baoshi/VGMPlayer/sw/doc/main_description.docx

Top state

Input: None

Events:

Event | Action
EVT_ENTRY
EVT_EXIT
EVT_START | Start browser state
EVT_OPEN_BRIGHTNESS_POPUP | Sender: [SETTING] button in Browser_Nodisk, Browser_Disk, Browser_Baddisk Popup brightness setting box
EVT_CLOSE_BRIGHTNESS_POPUP | Sender: Close brightness setting box
EVT_CLOSE_ALERT | Sender: Timer or manually sent from alert box. Close alert box

Browser state

Input: None

Events:

Event | Action
EVT_ENTRY | Create screen Create virtual buttons Setup inputs Create other UI elements Arm UI update timer
EVT_EXIT | Disarm UI update timer Delete virtual buttons (probably not necessary)
EVT_START | Start browser_nodisk state
EVT_BROWSER_UI_UPDATE | Update top bar

Browser_Nodisk state

Input:

Key | Button | | Keypad
| LVGL Event | Application Event
SETTING | LV_EVENT_SHORT_CLICKED | EVT_OPEN_BRIGHTNESS_POPUP
BACK | LV_EVENT_SHORT_CLICKED | EVT_BUTTON_BACK_CLICKED
PLAY
UP
DOWN

Events:

Event | Action
EVT_ENTRY | Setup inputs
EVT_EXIT
EVT_START | -
EVT_DISK_INSERTED | Sender: disk module Transit to browser_disk state

Browser_Baddisk state

Input:

Key | Button | | Keypad
| LVGL Event | Application Event
SETTING | LV_EVENT_SHORT_CLICKED | EVT_OPEN_BRIGHTNESS_POPUP
BACK | LV_EVENT_SHORT_CLICKED | EVT_BUTTON_BACK_CLICKED
PLAY
UP
DOWN

Events:

Event | Action
EVT_ENTRY | Setup inputs
EVT_EXIT
EVT_START | -
EVT_DISK_EJECTED | Sender: disk module. Transit to browser_nodisk state.

Browser_Disk state

Input:

Key | Button | | Keypad
| LVGL Event | Application Event
SETTING | LV_EVENT_SHORT_CLICKED | EVT_OPEN_BRIGHTNESS_POPUP
BACK | LV_EVENT_SHORT_CLICKED | EVT_BUTTON_BACK_CLICKED
PLAY | | | LV_KEY_ENTER
UP | | | LV_KEY_PREV
DOWN | | | LV_KEY_NEXT

Events:

Event | Action
EVT_ENTRY | Setup inputs and input group (for keypad) Create new catalog object from root folder or restore previous opened folder, if successful, populate file list; otherwise send EVT_DISK_ERROR event.
EVT_EXIT | Delete input group
EVT_START | -
EVT_BROWSER_PLAY_CLICKED | If clicked on a file, save history and transit to player state If clicked on a directory, save history, populate that directory (send EVT_DISK_ERROR if fail). If clicked on parent directory ([..]), send EVT_BUTTON_BACK_CLICKED. If clicked on page up/down, populate previous/next page.
EVT_BUTTON_BACK_CLICKED | If not root folder, discard one level of history, create catalog on parent folder and populate, send EVT_DISK_ERROR if failed.
EVT_DISK_ERROR | Sender: browser_disk event handler during disk I/O error. Transit to browser_baddisk state.
EVT_DISK_EJECTED | Sender: disk module. Transit to browser_nodisk state.

Player state

Input:

Key | Button | | Keypad
| LVGL Event | Application Event
SETTING | LV_EVENT_SHORT_CLICKED | EVT_OPEN_VOLUME_POPUP
BACK | LV_EVENT_SHORT_CLICKED | EVT_BUTTON_BACK_CLICKED
PLAY | LV_EVENT_SHORT_CLICKED | EVT_BUTTON_PLAY_CLICKED
UP | LV_EVENT_SHORT_CLICKED | EVT_BUTTON_UP_CLICKED
DOWN | LV_EVENT_SHORT_CLICKED | EVT_BUTTON_DOWN_CLICKED

Events:

Event | Action
EVT_ENTRY | Create screen. Create virtual buttons. Setup inputs. Create other UI elements. Arm UI update timer.
EVT_EXIT | Disarm UI update timer. Delete virtual buttons (probably not necessary).
EVT_START | Send EVT_BUTTON_PLAY_CLICKED.
EVT_BROWSER_UI_UPDATE | Update top bar.
EVT_BUTTON_PLAY_CLICKED | Get the current file, save history, determine file extension and transit to corresponding playing state. If error, popup alert.
EVT_PLAYER_PLAY_NEXT | Find next file (next or previous depending on nav_dir). If found, send EVT_BUTTON_PLAY_CLICKED. If reach end of catalog, save last played file in history. If disk error, send EVT_DISK_ERROR.
EVT_BUTTON_UP_CLICKED | Set nav_dir to up and send EVT_PLAYER_PLAY_NEXT.
EVT_BUTTON_DOWN_CLICKED | Set nav_dir to down and send EVT_PLAYER_PLAY_NEXT.
EVT_OPEN_VOLUME_POPUP | Sender: [SETTING] button in this state and sub-state. Pop up volume setting box.
EVT_CLOSE_VOLUME_POPUP | Sender: Volume popup upon [BACK] clicked. Close volume setting box.
EVT_CLOSE_VOLUME_POPUP_NEXT | Sender: Volume popup upon [SETTING] clicked. Send EVT_OPEN_BRIGHTNESS_POPUP.
EVT_BUTTON_BACK_CLICKED | Transit to browser_disk state.
EVT_DISK_ERROR | Transit to browser_baddisk state.
EVT_DISK_EJECTED | Sender: disk module. Transit to browser_nodisk state.
EVT_HEADPHONE_PLUGGED | If volume setting box already shown, refresh it
EVT_HEADPHONE_UNPLUGGED | If volume setting box already shown, refresh it

Player_S16 state

Input:

Key | Button | | Keypad
| LVGL Event | Application Event
SETTING | LV_EVENT_SHORT_CLICKED | EVT_OPEN_VOLUME_POPUP
BACK | LV_EVENT_SHORT_CLICKED | EVT_BUTTON_BACK_CLICKED
PLAY | LV_EVENT_SHORT_CLICKED | EVT_BUTTON_PLAY_CLICKED
UP | LV_EVENT_SHORT_CLICKED | EVT_BUTTON_UP_CLICKED
DOWN | LV_EVENT_SHORT_CLICKED | EVT_BUTTON_DOWN_CLICKED

Events:

Event | Action
EVT_ENTRY | Setup inputs. Create decoder. Setup audio system and start playback.
EVT_EXIT | Finish audio system. If config dirty, save config. (possible config changed during playback) Destroy decoder.
EVT_START
EVT_BUTTON_PLAY_CLICKED | Pause/Resume playback.
EVT_BUTTON_BACK_CLICKED | Stop audio playback. Set nav_dir to 0. Audio system will send EVT_AUDIO_SONG_ENDDED after last audio sample played.
EVT_BUTTON_UP_CLICKED | Stop audio playback. Set nav_dir to up. Audio system will send EVT_AUDIO_SONG_ENDDED after last audio sample played.
EVT_BUTTON_DOWN_CLICKED | Stop audio playback. Set nav_dir to down. Audio system will send EVT_AUDIO_SONG_ENDDED after last audio sample played.
EVT_AUDIO_SONG_ENDDED | If nav_dir is 0, transit to browser_disk state. Otherwise send EVT_PLAYER_PLAY_NEXT (player state to handle)

Popup Brightness

Input:

Key | Button | | Keypad
| LVGL Event | Application Event
SETTING | LV_EVENT_SHORT_CLICKED | EVT_CLOSE_BRIGHTNESS_POPUP
BACK | LV_EVENT_SHORT_CLICKED | EVT_CLOSE_BRIGHTNESS_POPUP
PLAY
UP | | | LV_KEY_UP
DOWN | | | LV_KEY_DOWN

Creation | Called by top state when handling EVT_OPEN_BRIGHTNESS_POPUP. Save current input configuration. Setup input. Create slider box, bind slider to UP/DOWN and set slider VALUE_CHANGED callback. Setup auto close timer to emit EVT_CLOSE_BRIGHTNESS (handled by top state).
Callback | Change brightness. Set config dirty. Reset auto close timer.
Close | Called by top state when handling EVT_CLOSE_BRIGHTNESS_POPUP. Save config if not busy and config dirty. Delete input group. Close slider box. Restore original input configuration.

Popup Volume

Input:

Key | Button | | Keypad
| LVGL Event | Application Event
SETTING | LV_EVENT_SHORT_CLICKED | EVT_CLOSE_VOLUME_POPUP_NEXT
BACK | LV_EVENT_SHORT_CLICKED | EVT_CLOSE_VOLUME_POPUP
PLAY
UP | | | LV_KEY_UP
DOWN | | | LV_KEY_DOWN

Creation | Called by player state when handling EVT_OPEN_VOLUME_POPUP. Save current input configuration. Setup input. Create slider box, bind slider to UP/DOWN and set slider VALUE_CHANGED callback.
Callback | Change volume for active device. Set config dirty. Reset auto close timer.
Close | Called by player state when handling EVT_CLOSE_VOLUME_POPUP and EVT_CLOSE_VOLUME_POPUP_NEXT. Save config if not busy and config dirty. Delete input group. Close slider box. Restore original input configuration.

Popup Alert

Input:

Key | Button | | Keypad
| LVGL Event | Application Event
SETTING
BACK
PLAY | | | LV_KEY_ENTER
UP
DOWN

Creation | Called by player state on various occasions when error occurred. Save current input configuration. Setup input. Create alert popup. Bind KEY_ENTER callback. Setup auto close timer to emit EVT_CLOSE_ALERT (handled by top state).
Callback | When ENTER key pressed, stop auto close timer. When ENTER key clicked, send EVT_CLOSE_ALERT (handled by top state).
Close | Called by top state when handling EVT_CLOSE_ALERT. Delete input group. Close alert. Restore original input configuration.
