baoshi/VGMPlayer/hw/doc/XKTF-015-G.pdf

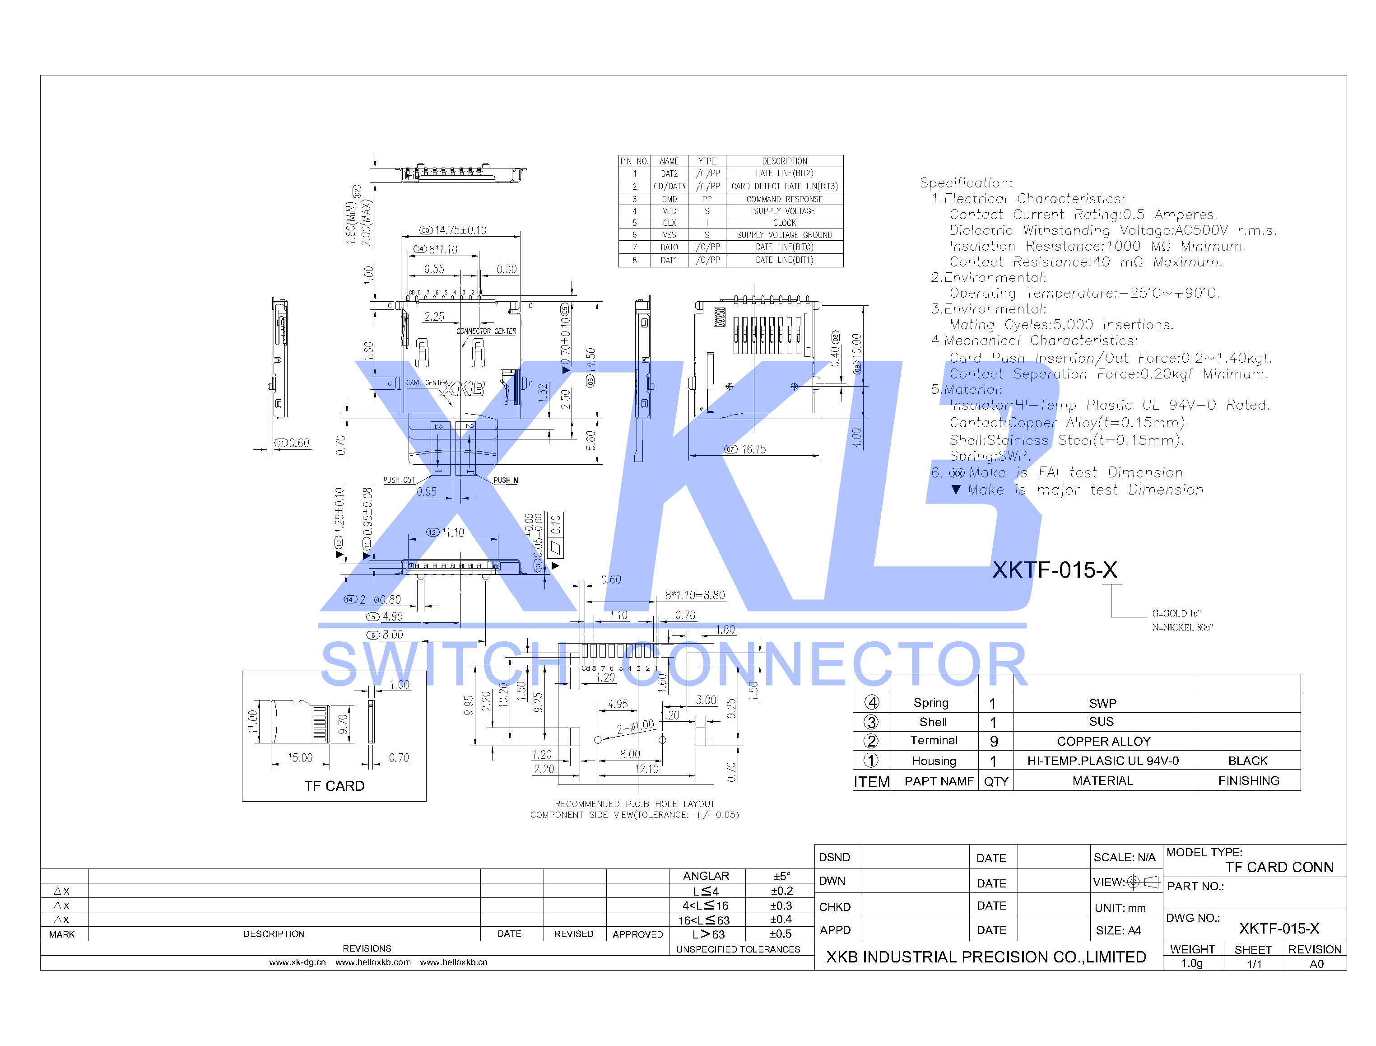
[picture p1: page 1]
