baoshi/VGMPlayer/hw/VGMPlayer.kicad_pcb

## KiCad design hw/VGMPlayer.kicad_pcb (2023-02-13)

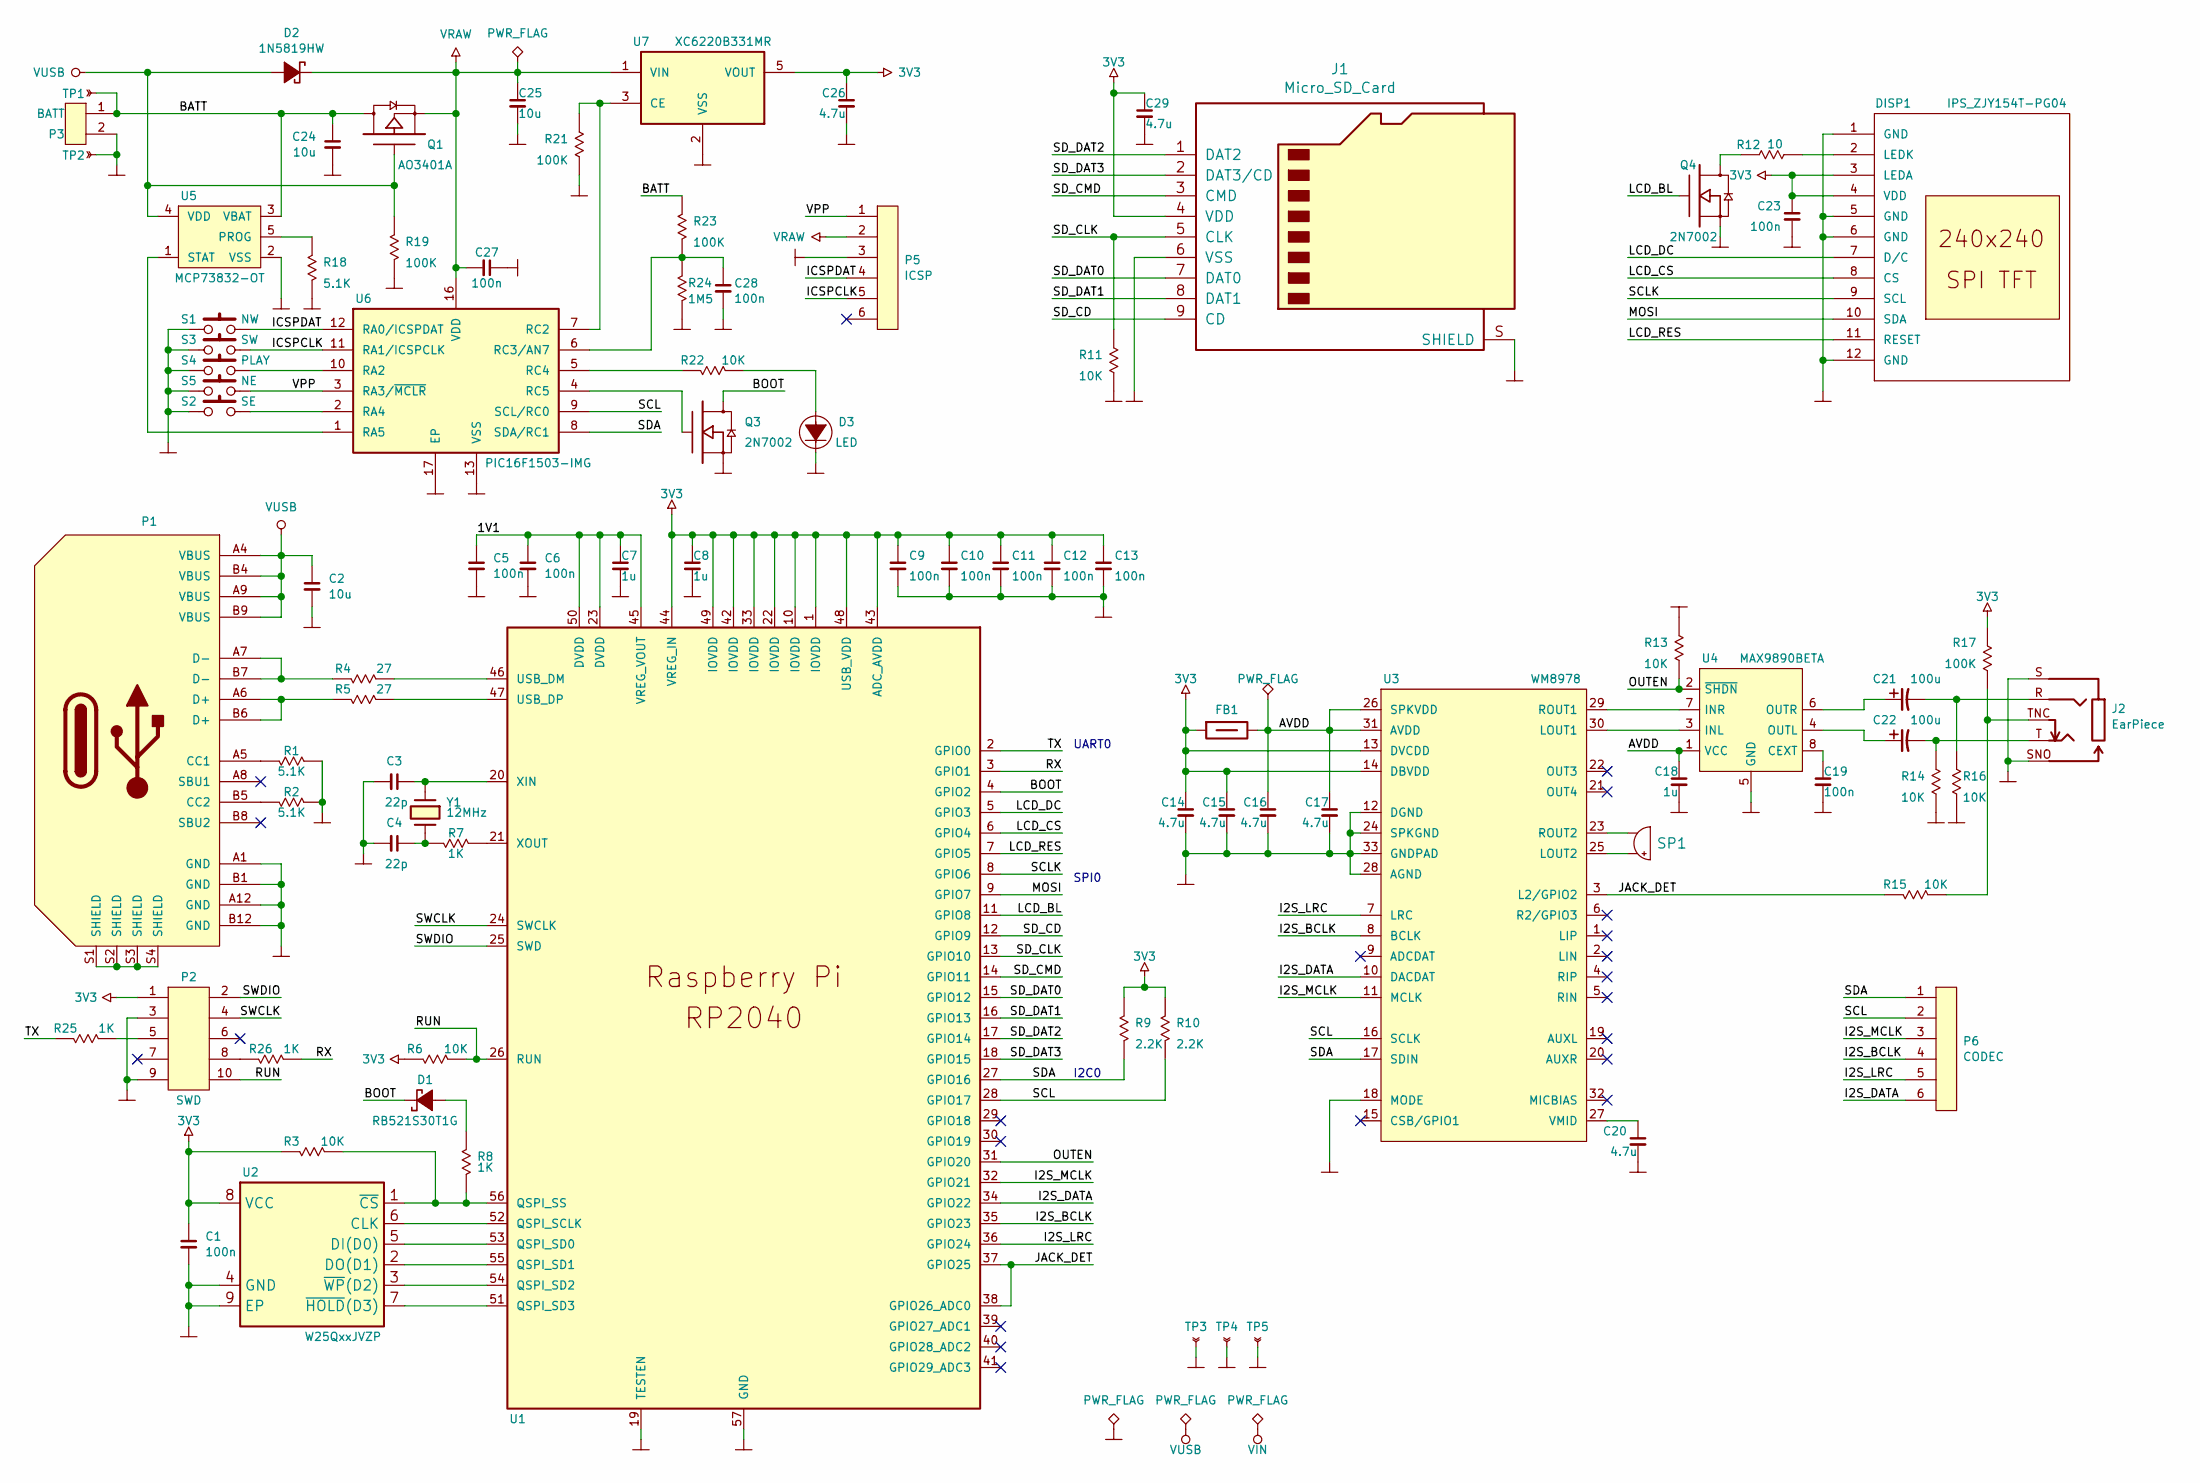
[picture p3: schematic VGMPlayer.kicad_sch]

Parts:
C1, C5, C6, C9, C10, C11, C12, C13, C19, C23, C27, C28: 100n; C_0402
C2, C25: 10u; C_0603
C3, C4: 22p; C_0402
C7, C8, C18: 1u; C_0603
C14, C26, C29: 4.7u; C_0603
C15, C16, C17, C20: 4.7u; C_0603; JLCPN C77044
C21, C22: 100u; CP_5x5.3
C24: 10u; C_0603; JLCPN C77044
D1: RB521S30T1G; D_SOD-523
D2: 1N5819HW; D_SOD-123
D3: LED; D_LED_0805_Edge_Lit
DISP1: IPS_ZJY154T-PG04
FB1: FB; L_0805
J1: Micro_SD_Card; XKB_XKTF-015-X
J2: EarPiece; XKB_PJ-327A0-SMT
P1: USB_C_Receptacle_16P; HRO_TYPE-C-31-M-12
P2: SWD; PINHDR-THT-50mil-02x05
P3: BATT; MLX_PicoBlade-Horz-01x02-1.25P
P5: ICSP; PINHDR-THT-50mil-01x06
P6: CODEC; PINHDR-THT-50mil-01x06
Q1: AO3401A; SOT-23-3
Q3, Q4: 2N7002; SOT-523
R1, R2, R18: 5.1K; R_0402
R3, R6, R11, R13, R14, R15, R16, R22: 10K; R_0402
R4, R5: 27; R_0402
R7, R8, R25, R26: 1K; R_0402
R9, R10: 2.2K; R_0402
R12: 10; R_0603
R17, R19, R21, R23: 100K; R_0402
R24: 1M5; R_0402
S1: NW; MultiButton
S2: SE; MultiButton
S3: SW; MultiButton
S4: PLAY; MultiButton
S5: NE; MultiButton
SP1: Speaker; iPhone8Speaker
TP1, TP2, TP3, TP4, TP5: TP; TP_THT-Pad-0.8
U1: RP2040
U2: W25QxxJVZP; WSON-8-1EP_5x6x1.27P_EP4.3x3.4
U3: WM8978; QFN-32-1EP_5x5x0.5P_EP3.45
U4: MAX9890BETA; TDFN-8-1EP_3x3x0.65P_EP2.3x1.5
U5: MCP73832-OT; SOT-23-5
U6: PIC16F1503-IMG; QFN-16-1EP_3x3x0.5P_EP1.1
U7: XC6220B331MR; SOT-23-5
Y1: 12MHz; XTAL_3225_4P

Connections:
3V3: C1.1, C8.1, C9.1, C10.1, C11.1, C12.1, C13.1, C14.1, C15.1, C23.1, C26.1, C29.1, DISP1.3 (LEDA), DISP1.4 (VDD), FB1.2, J1.4 (VDD), P2.1, R3.2, R6.2, R9.1, R10.1, R17.1, U1.1 (IOVDD), U1.10 (IOVDD), U1.22 (IOVDD), U1.33 (IOVDD), U1.42 (IOVDD), U1.43 (ADC_AVDD), U1.44 (VREG_IN), U1.48 (USB_VDD), U1.49 (IOVDD), U2.8 (VCC), U3.13 (DVCDD), U3.14 (DBVDD), U7.5 (VOUT)
/1V1: C5.1, C6.1, C7.1, U1.23 (DVDD), U1.45 (VREG_VOUT), U1.50 (DVDD)
/AVDD: C16.1, C17.1, C18.1, FB1.1, U3.26 (SPKVDD), U3.31 (AVDD), U4.1 (VCC)
/BATT: C24.1, P3.1, Q1.3 (D), R23.1, TP1.1, U5.3 (VBAT)
/BOOT: D1.K, Q3.3 (D), U1.4 (GPIO2)
/I2S_BCLK: P6.4, U1.35 (GPIO23), U3.8 (BCLK)
/I2S_DATA: P6.6, U1.34 (GPIO22), U3.10 (DACDAT)
/I2S_LRC: P6.5, U1.36 (GPIO24), U3.7 (LRC)
/I2S_MCLK: P6.3, U1.32 (GPIO21), U3.11 (MCLK)
/ICSPCLK: P5.5, S3.2, U6.11 (RA1/ICSPCLK)
/ICSPDAT: P5.4, S1.2, U6.12 (RA0/ICSPDAT)
/JACK_DET: R15.2, U1.37 (GPIO25), U1.38 (GPIO26_ADC0), U3.3 (L2/GPIO2)
/LCD_BL: Q4.1 (G), U1.11 (GPIO8)
/LCD_CS: DISP1.8 (CS), U1.6 (GPIO4)
/LCD_DC: DISP1.7 (D/C), U1.5 (GPIO3)
/LCD_RES: DISP1.11 (RESET), U1.7 (GPIO5)
/MOSI: DISP1.10 (SDA), U1.9 (GPIO7)
/OUTEN: R13.2, U1.31 (GPIO20), U4.2 (~SHDN)
/RUN: P2.10, R6.1, U1.26 (RUN)
/RX: R26.1, U1.3 (GPIO1)
/SCL: P6.2, R10.2, U1.28 (GPIO17), U3.16 (SCLK), U6.9 (SCL/RC0)
/SCLK: DISP1.9 (SCL), U1.8 (GPIO6)
/SDA: P6.1, R9.2, U1.27 (GPIO16), U3.17 (SDIN), U6.8 (SDA/RC1)
/SD_CD: J1.9 (CD), U1.12 (GPIO9)
/SD_CLK: J1.5 (CLK), R11.1, U1.13 (GPIO10)
/SD_CMD: J1.3 (CMD), U1.14 (GPIO11)
/SD_DAT0: J1.7 (DAT0), U1.15 (GPIO12)
/SD_DAT1: J1.8 (DAT1), U1.16 (GPIO13)
/SD_DAT2: J1.1 (DAT2), U1.17 (GPIO14)
/SD_DAT3: J1.2 (DAT3/CD), U1.18 (GPIO15)
/SWCLK: P2.4, U1.24 (SWCLK)
/SWDIO: P2.2, U1.25 (SWD)
/TX: R25.2, U1.2 (GPIO0)
/VPP: P5.1, S5.2, U6.3 (RA3/~MCLR)
GND: C1.2, C2.2, C3.2, C4.2, C5.2, C6.2, C7.2, C8.2, C9.2, C10.2, C11.2, C12.2, C13.2, C14.2, C15.2, C16.2, C17.2, C18.2, C19.2, C20.2, C23.2, C24.2, C25.2, C26.2, C27.1, C28.2, C29.2, D3.K, DISP1.1 (GND), DISP1.5 (GND), DISP1.6 (GND), DISP1.12 (GND), J1.6 (VSS), J1.S (SHIELD), J2.S, J2.SNO, P1.A1 (GND), P1.A12 (GND), P1.B1 (GND), P1.B12 (GND), P2.3, P2.9, P3.2, P5.3, Q3.2 (S), Q4.2 (S), R1.1, R2.1, R11.2, R13.1, R14.2, R16.2, R18.2, R19.2, R21.2, R24.2, S1.1, S2.1, S3.1, S4.1, S5.1, TP2.1, TP3.1, TP4.1, TP5.1, U1.19 (TESTEN), U1.57 (GND), U2.4 (GND), U2.9 (EP), U3.12 (DGND), U3.18 (MODE), U3.24 (SPKGND), U3.28 (AGND), U3.33 (GNDPAD), U4.5 (GND), U4.9 (GND), U5.2 (VSS), U6.13 (VSS), U6.17 (EP), U7.2 (VSS)
unnamed: C3.1, U1.20 (XIN), Y1.1 (OSC1)
unnamed: C4.1, R7.2, Y1.3 (OSC2)
unnamed: C19.1, U4.8 (CEXT)
unnamed: C20.1, U3.27 (VMID)
unnamed: C21.1, U4.6 (OUTR)
unnamed: C21.2, J2.R, R16.1
unnamed: C22.1, U4.4 (OUTL)
unnamed: C22.2, J2.T, R14.1
unnamed: C28.1, R23.2, R24.1, U6.6 (RC3/AN7)
unnamed: D1.A, R8.1
unnamed: D3.A, R22.2
unnamed: DISP1.2 (LEDK), R12.1
unnamed: J2.TNC, R15.1, R17.2
unnamed: P1.A5 (CC1), R1.2
unnamed: P1.A6 (D+), P1.B6 (D+), R5.2
unnamed: P1.A7 (D-), P1.B7 (D-), R4.2
unnamed: P1.B5 (CC2), R2.2
unnamed: P1.S1 (SHIELD), P1.S2 (SHIELD), P1.S3 (SHIELD), P1.S4 (SHIELD)
unnamed: P2.5, R25.1
unnamed: P2.8, R26.2
unnamed: Q3.1 (G), U6.4 (RC5)
unnamed: Q4.3 (D), R12.2
unnamed: R3.1, R8.2, U1.56 (QSPI_SS), U2.1 (~CS)
unnamed: R4.1, U1.46 (USB_DM)
unnamed: R5.1, U1.47 (USB_DP)
unnamed: R7.1, U1.21 (XOUT)
unnamed: R18.1, U5.5 (PROG)
unnamed: R21.1, U6.7 (RC2), U7.3 (CE)
unnamed: R22.1, U6.5 (RC4)
unnamed: S2.2, U6.2 (RA4)
unnamed: S4.2, U6.10 (RA2)
unnamed: SP1.1, U3.25 (LOUT2)
unnamed: SP1.2, U3.23 (ROUT2)
unnamed: U1.51 (QSPI_SD3), U2.7 (~HOLD(D3))
unnamed: U1.52 (QSPI_SCLK), U2.6 (CLK)
unnamed: U1.53 (QSPI_SD0), U2.5 (DI(D0))
unnamed: U1.54 (QSPI_SD2), U2.3 (~WP(D2))
unnamed: U1.55 (QSPI_SD1), U2.2 (DO(D1))
unnamed: U3.29 (ROUT1), U4.7 (INR)
unnamed: U3.30 (LOUT1), U4.3 (INL)
unnamed: U5.1 (STAT), U6.1 (RA5)
VRAW: C25.1, C27.2, D2.K, P5.2, Q1.2 (S), U6.16 (VDD), U7.1 (VIN)
VUSB: C2.1, D2.A, P1.A4 (VBUS), P1.A9 (VBUS), P1.B4 (VBUS), P1.B9 (VBUS), Q1.1 (G), R19.1, U5.4 (VDD)

Notes on the sheet:
UART0
SPI0
I2C0

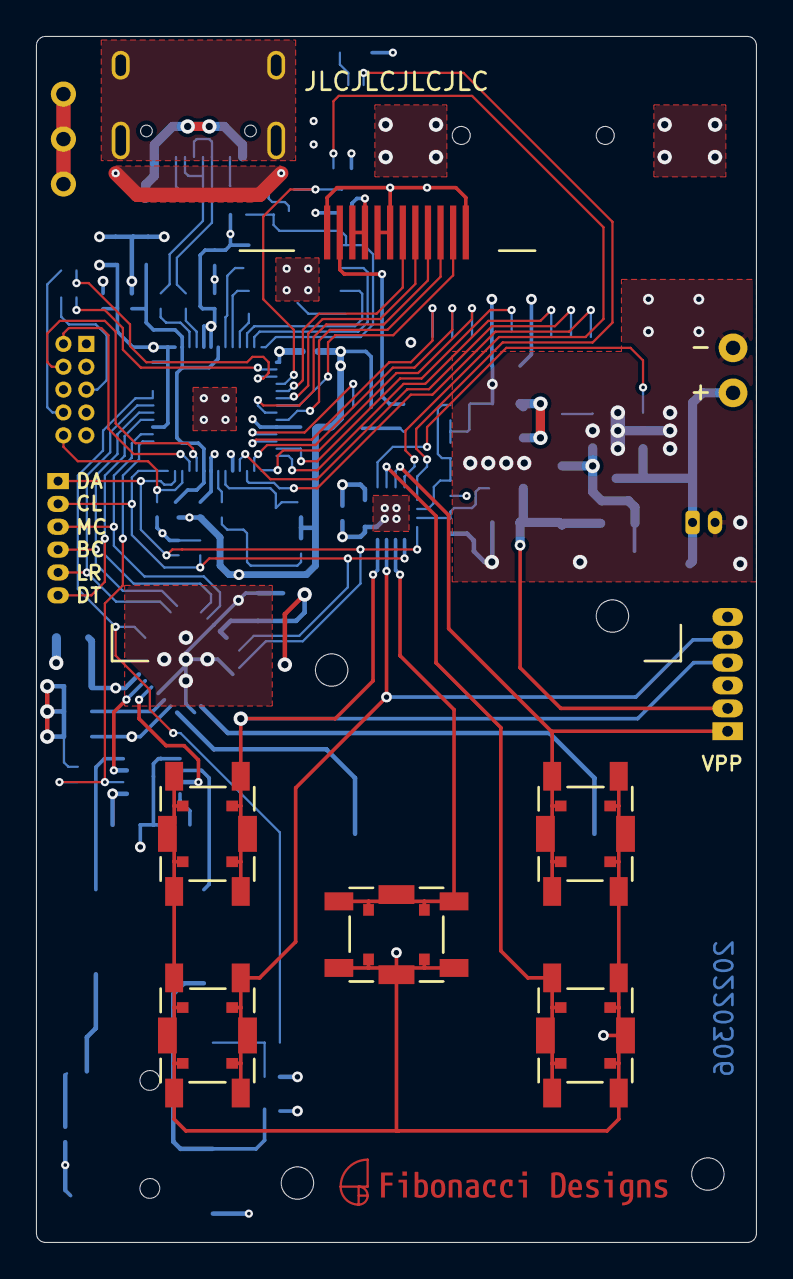
[picture p4: board VGMPlayer.kicad_pcb from above]

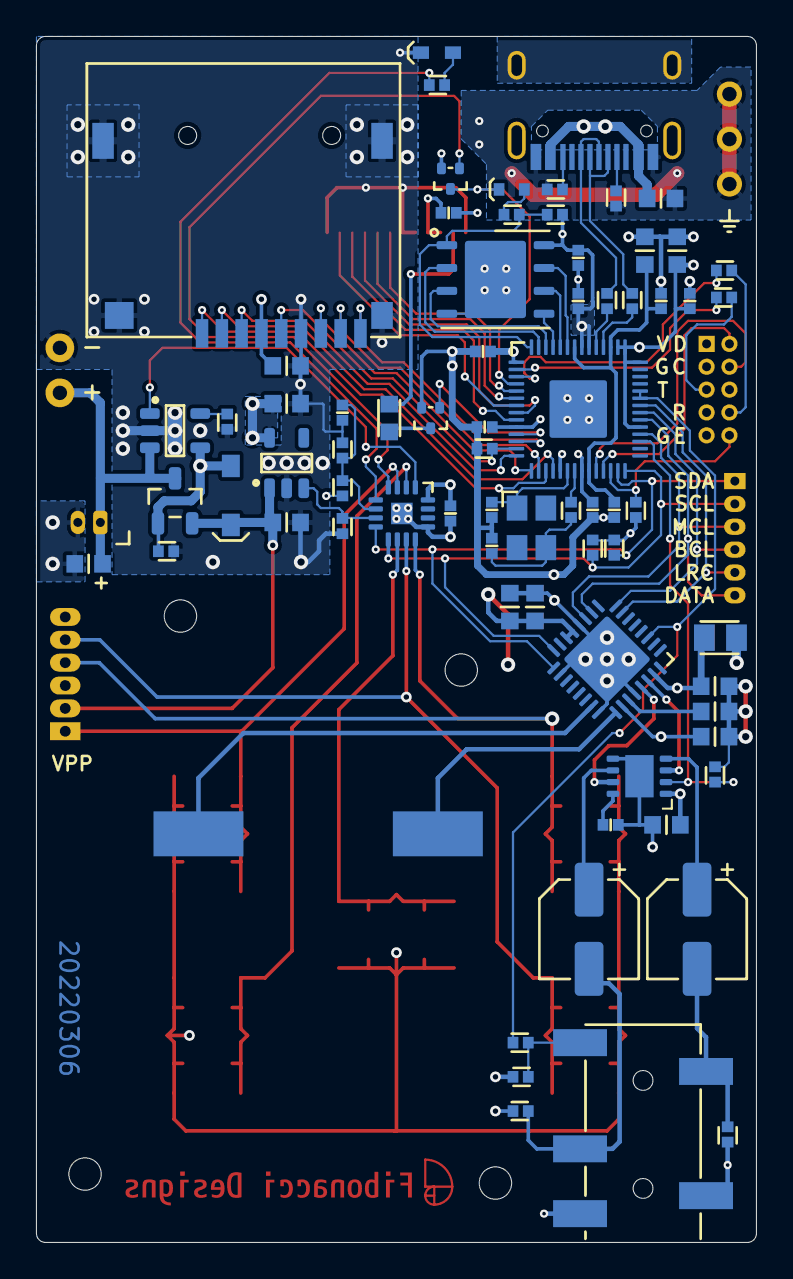
[picture p5: board VGMPlayer.kicad_pcb from below]

Board: 4 copper layers, 40.0 x 67.0 mm, 89 parts (82 on the bottom side), 78 nets.

Other parts of the board:
kibuzzard-62236962: G***; kibuzzard-62236962
