baoshi/VGMPlayer/sw/main/bsp/vgmpboard.h

#pragma once

#ifndef PICO_DEFAULT_UART
#define PICO_DEFAULT_UART 0
#endif
#ifndef PICO_DEFAULT_UART_TX_PIN
#define PICO_DEFAULT_UART_TX_PIN 0
#endif
#ifndef PICO_DEFAULT_UART_RX_PIN
#define PICO_DEFAULT_UART_RX_PIN 1
#endif


// Default I2C
#ifndef PICO_DEFAULT_I2C
#define PICO_DEFAULT_I2C       0
#endif
#ifndef PICO_DEFAULT_I2C_SDA_PIN
#define PICO_DEFAULT_I2C_SDA_PIN   16
#endif
#ifndef PICO_DEFAULT_I2C_SCL_PIN
#define PICO_DEFAULT_I2C_SCL_PIN   17
#endif

// SPI flash

#define PICO_BOOT_STAGE2_CHOOSE_W25Q080 1

#ifndef PICO_FLASH_SPI_CLKDIV
#define PICO_FLASH_SPI_CLKDIV 2
#endif

// PICO_FLASH_SIZE_BYTES is checked against writing address in flash.c
#ifndef PICO_FLASH_SIZE_BYTES
#define PICO_FLASH_SIZE_BYTES (16 * 1024 * 1024)
#endif

// All boards have B1 RP2040
#ifndef PICO_FLOAT_SUPPORT_ROM_V1
#define PICO_FLOAT_SUPPORT_ROM_V1 1
#endif

#ifndef PICO_DOUBLE_SUPPORT_ROM_V1
#define PICO_DOUBLE_SUPPORT_ROM_V1 1

#endif
