baoshi/VGMPlayer/sw/ec/state_timeout.c

#include <xc.h>
#include <stdint.h>
#include "global.h"
#include "tick.h"
#include "io.h"
#include "led.h"
#include "state.h"

// TIMEOUT State
// Entry:
//   LED set to PRE_OFF pattern
// Exit:
//   None
// Update:
//   After TIME_NOTICE_OFF elapses, wait button release and enter MAIN_STATE_OFF state
//   

static uint8_t _timestamp;

void state_timeout_entry(void)
{
    led_set(LED_BLINK_PRE_OFF);
    _timestamp = systick;
}


uint8_t state_timeout_update(void)
{
    led_update();
    if ((uint8_t)(systick - _timestamp) >= (TIME_NOTICE_OFF / MS_PER_TICK))
    {
        io_debounce_inputs();
        if ((io_input_state & IO_STATUS_MASK_BUTTONS) == IO_STATUS_MASK_BUTTONS)  // Wait for all button release
        {
            return MAIN_STATE_OFF;
        }
    }
    return MAIN_STATE_TIMEOUT;
}
