baoshi/VGMPlayer/sw/main/modules/audio/audio.c

#include <string.h>
#include <inttypes.h>
#include <hardware/structs/bus_ctrl.h>
#include <hardware/gpio.h>
#include <pico/multicore.h>
#include <pico/util/queue.h>
#include <pico/time.h>
#include "hw_conf.h"
#include "sw_conf.h"
#include "my_debug.h"
#include "tick.h"
#include "event_ids.h"
#include "event_queue.h"
#include "wm8978.h"
#include "i2s.h"
#include "audio.h"


// Playback states
typedef enum
{
    PLAY_NONE = 0,
    PLAY_NORMAL,
    PLAY_SILENCE,
    PLAY_GAP,
    PLAY_GAP_PAUSED
} playback_state_t;


// command send to playback_proc
enum
{
    CMD_NONE = 0,
    CMD_PAUSE,
    CMD_RESUME,
    CMD_STOP,
    CMD_TERM
};


// context used during playback, shared by audio_xxx and playback_proc on core 1
typedef struct playback_ctx_s
{
    decoder_t *decoder;         // decoder interface
    playback_state_t state;     // playing state
} playback_ctx_t;
static playback_ctx_t __audio_ram("audio") _playback;


// "sampling" buffer for UI access, not in "audio" ram
audio_sampling_buffer_t audio_sampling_buffer;


// Jack detection fsm
#define JACK_DEBOUNCE_MS 100
static uint32_t _jack_timestamp = 0;
static enum jack_states
{
    JACK_NONE,
    JACK_EMPTY,
    JACK_BOUNCING_IN,
    JACK_INSERTED,
    JACK_BOUNCING_OUT
} _jack_state;


void audio_preinit()
{
    AUD_LOGD("Audio: PreInit @ %d\n", tick_millis());
    audio_mem_init();
    audio_cbuf_init();
    memset(&_playback, 0, sizeof(playback_ctx_t));
    memset(&audio_sampling_buffer, 0, sizeof(audio_sampling_buffer_t));
    mutex_init(&(audio_sampling_buffer.lock));
    // Disable jack output at beginning
    gpio_init(JACK_OUTEN_PIN);
    gpio_put(JACK_OUTEN_PIN, false);
    gpio_set_dir(JACK_OUTEN_PIN, GPIO_OUT);
    // Initailize WM8978
    wm8978_preinit();
    // Enable jack detection GPIO
    gpio_init(JACK_DETECTION_PIN);
    gpio_disable_pulls(JACK_DETECTION_PIN);
    gpio_set_dir(JACK_DETECTION_PIN, GPIO_IN);
    gpio_init(JACK_DETECTION_ADC_PIN);
    gpio_disable_pulls(JACK_DETECTION_ADC_PIN);
    gpio_set_dir(JACK_DETECTION_ADC_PIN, GPIO_IN);
    _jack_state = JACK_EMPTY;
    _jack_timestamp = 0;
}


void audio_postinit()
{
    AUD_LOGD("Audio: PostInit @ %d\n", tick_millis());
    wm8978_postinit();
    audio_set_headphone_volume(config.volume_headphone);
    audio_set_speaker_volume(config.volume_speaker);
    audio_jack_enable(true);
}


void audio_close()
{
    wm8978_powerdown();
    _jack_state = JACK_NONE;
}


static inline unsigned int decode_samples(decoder_t *decoder, uint32_t *buf, unsigned int len)
{
    int samples = 0;
    if (decoder->get_sample_s16)
    {
        absolute_time_t start = get_absolute_time();
        // get_sample_s16 returns 16bit buffer
        int16_t *buf16 = (int16_t *)buf;
        samples = decoder->get_sample_s16(decoder, buf16, len);
        // fill sampling buffer only if it is complete
        if (samples == AUDIO_FRAME_LENGTH)
        {
            if (mutex_try_enter(&(audio_sampling_buffer.lock), NULL))
            {
                memcpy(audio_sampling_buffer.buffer, buf16, len * sizeof(int16_t)); // avoid GCC warning, samples == len here
                audio_sampling_buffer.good = true;
                mutex_exit(&(audio_sampling_buffer.lock));
            }
        }
        // expand 16bit to 32bit for audio output
        // |AA|BB|CC|DD|EE| --> |AA|AA|BB|BB|CC|CC|DD|DD|EE|EE|  (view as int16_t)
        for (int i = samples - 1; i >= 0; --i)
        {
            buf16[i + i + 1] = buf16[i];
            buf16[i + i] = buf16[i];
        }
        absolute_time_t end = get_absolute_time();
        int64_t us = absolute_time_diff_us(start, end);
        if ((samples > 0) && (us > 1000000 * samples / 44100))
            AUD_LOGD("Audio/core1: %d samples in %lld us\n", samples, us);
    }
    return (unsigned int)samples;
}


static void playback_proc()
{
    static audio_progress_t progress;

    AUD_LOGD("Audio/core1: playback entry\n");
    decoder_t *decoder = _playback.decoder;
    uint32_t sample;
    unsigned int num_samples;
    register int16_t l, ll, r, rr;
    register int x, i;
    bool finished = false;
    uint32_t cmd;
    int gaps = AUDIO_SONG_GAP_MS * AUDIO_SAMPLE_RATE / AUDIO_FRAME_LENGTH / 1000; // number of silence buffer to send before finish the song

    audio_cbuf_reset();
    multicore_fifo_drain();
    _playback.state = PLAY_NORMAL;
    progress.total_samples = decoder->total_samples;
    progress.played_samples = 0;
    // first audio buffer is a ramp up from 0 to first sound sample
    num_samples = decode_samples(decoder, &sample, 1);
    if (num_samples == 0) sample = 0;   // no sample from decoder, just make a buffer of 0 and let playing finish by itself
    progress.played_samples += num_samples;
    audio_frame_t *frame = audio_cbuf_get_write_buffer();
    MY_ASSERT(frame != NULL);
    l = (int16_t)(sample >> 16);
    r = (int16_t)(sample & 0xffff);
    for (int i = 0; i < AUDIO_FRAME_LENGTH - 1; ++i)
    {
        ll = l * i / (AUDIO_FRAME_LENGTH - 2);
        rr = r * i / (AUDIO_FRAME_LENGTH - 2);
        frame->data[i] = ((uint32_t)ll) << 16 | (uint16_t)rr;
    }
    frame->data[AUDIO_FRAME_LENGTH - 1] = sample;
    frame->length = AUDIO_FRAME_LENGTH;
    audio_cbuf_finish_write();
    // fill remaining buffer with actual samples
    while (1)
    {
        frame = audio_cbuf_get_write_buffer();
        if (NULL == frame) break;
        num_samples = decode_samples(decoder, frame->data, AUDIO_FRAME_LENGTH);
        frame->length = num_samples;
        progress.played_samples += num_samples;
        audio_cbuf_finish_write();
        if (0 == num_samples) break;
    }
    AUD_LOGD("Audio/core1: init I2S\n");
    i2s_init();
    wm8978_mute(false);
    i2s_start_playback();
    // play loop
    AUD_LOGD("Audio/core1: enter play loop\n");
    while (!finished)
    {
        audio_frame_t *frame = audio_cbuf_get_write_buffer();
        if (NULL == frame)  // audio circular buffer full, wait.
        {
            tight_loop_contents();
            continue;    
        }
        // we have empty frame now, see if we received any command
        if (multicore_fifo_rvalid())
        {
            cmd = sio_hw->fifo_rd;
        }
        else
        {
            cmd = CMD_NONE;
        }

        switch (_playback.state)
        {

        case PLAY_NORMAL:
            // PLAY_NORMAL:
            // cmd == CMD_NONE   :  Continue generate sample buffer, if no more buffer, send ramp down then enter PLAY_GAP
            // cmd == CMD_PAUSE  :  Generate ramp down buffer and set state to PLAY_SILENCE
            // cmd == CMD_RESUME :  Do nothing
            // cmd == CMD_STOP   :  Generate 0 length buffer and set finished to true            
            // cmd == CMD_TERM   :  Generate 0 length buffer and set finished to true
            switch (cmd)
            {
            case CMD_NONE:
                num_samples = decode_samples(decoder, frame->data, AUDIO_FRAME_LENGTH);
                frame->length = num_samples;
                audio_cbuf_finish_write();
                if (i2s_buffer_underrun)    // If I2S buffer underrun occurred, resume sending
                    i2s_resume_playback();
                if (num_samples != 0)
                {
                    // notify UI 
                    progress.played_samples += num_samples;
                    event_t e;
                    e.code = EVT_AUDIO_PROGRESS;
                    e.param = (void *)(&progress);
                    event_queue_push_back(&e, true);
                    // save last sample for ramp use
                    sample = frame->data[num_samples - 1];
                } 
                else
                {
                    // no more samples from decoder, send ramp down then enter PLAY_GAP
                    AUD_LOGD("Audio/core1: decoding finished, sending gap\n");
                    l = (int16_t)(sample >> 16);
                    r = (int16_t)(sample & 0xffff);
                    for (i = 0; i < AUDIO_FRAME_LENGTH; ++i)
                    {
                        x = AUDIO_FRAME_LENGTH - 1 - i;
                        ll = l * x / (AUDIO_FRAME_LENGTH - 1);
                        rr = r * x / (AUDIO_FRAME_LENGTH - 1);
                        frame->data[i] = ((uint32_t)ll) << 16 | (uint16_t)rr;
                    }
                    frame->length = AUDIO_FRAME_LENGTH;
                    audio_cbuf_finish_write();
                    if (i2s_buffer_underrun)    // If I2S buffer underrun occurred, resume sending
                        i2s_resume_playback();
                    --gaps;
                    _playback.state = PLAY_GAP;
                    break;
                }
                break;
            case CMD_PAUSE:
                AUD_LOGD("Audio/core1: CMD_PAUSE\n");
                l = (int16_t)(sample >> 16);
                r = (int16_t)(sample & 0xffff);
                for (i = 0; i < AUDIO_FRAME_LENGTH; ++i)
                {
                    x = AUDIO_FRAME_LENGTH - 1 - i;
                    ll = l * x / (AUDIO_FRAME_LENGTH - 1);
                    rr = r * x / (AUDIO_FRAME_LENGTH - 1);
                    frame->data[i] = ((uint32_t)ll) << 16 | (uint16_t)rr;
                }
                frame->length = AUDIO_FRAME_LENGTH;
                audio_cbuf_finish_write();
                if (i2s_buffer_underrun)    // If I2S buffer underrun occurred, resume sending
                    i2s_resume_playback();
                _playback.state = PLAY_SILENCE;
                break;
            case CMD_STOP:
                AUD_LOGD("Audio/core1: CMD_STOP\n");
                frame->length = 0;
                audio_cbuf_finish_write();
                if (i2s_buffer_underrun)    // If I2S buffer underrun occurred, resume sending
                    i2s_resume_playback();
                finished = true;
                break;
            case CMD_TERM:
                AUD_LOGD("Audio/core1: CMD_TERM\n");
                frame->length = 0;
                audio_cbuf_finish_write();
                if (i2s_buffer_underrun)    // If I2S buffer underrun occurred, resume sending
                    i2s_resume_playback();
                finished = true;
                break;
            }
            break;

        case PLAY_SILENCE:
            // PLAY_SILENCE:
            // cmd == CMD_NONE   :  Continue generate silence
            // cmd == CMD_PAUSE  :  Do nothing
            // cmd == CMD_RESUME :  Generate ramp up buffer and set state to PLAY_NORMAL
            // cmd == CMD_STOP   :  Generate 0 length sample and set finished to true
            // cmd == CMD_TERM   :  Generate 0 length sample and set finished to true
            switch (cmd)
            {
            case CMD_NONE:
                memset(frame->data, 0, AUDIO_FRAME_LENGTH * sizeof(uint32_t));
                frame->length = AUDIO_FRAME_LENGTH;
                audio_cbuf_finish_write();
                if (i2s_buffer_underrun)    // If I2S buffer underrun occurred, resume sending
                    i2s_resume_playback();
                break;
            case CMD_RESUME:
                l = (int16_t)(sample >> 16);
                r = (int16_t)(sample & 0xffff);
                for (i = 0; i < AUDIO_FRAME_LENGTH; ++i)
                {
                    ll = l * i / (AUDIO_FRAME_LENGTH - 1);
                    rr = r * i / (AUDIO_FRAME_LENGTH - 1);
                    frame->data[i] = ((uint32_t)ll) << 16 | (uint16_t)rr;
                }
                frame->length = AUDIO_FRAME_LENGTH;
                audio_cbuf_finish_write();
                if (i2s_buffer_underrun)    // If I2S buffer underrun occurred, resume sending
                    i2s_resume_playback();
                _playback.state = PLAY_NORMAL;
                break;
            case CMD_STOP:
                AUD_LOGD("Audio/core1: CMD_STOP\n");
                frame->length = 0;
                audio_cbuf_finish_write();
                if (i2s_buffer_underrun)    // If I2S buffer underrun occurred, resume sending
                    i2s_resume_playback();
                finished = true;
                break;
            case CMD_TERM:
                AUD_LOGD("Audio/core1: CMD_TERM\n");
                frame->length = 0;
                audio_cbuf_finish_write();
                if (i2s_buffer_underrun)    // If I2S buffer underrun occurred, resume sending
                    i2s_resume_playback();
                finished = true;
                break;
            }
            break;

        case PLAY_GAP:
            // PLAY_GAP:
            // cmd == CMD_NONE   :  Continue generate silence and decrease gap. If gap==0 send 0 length buffer and set finished to true
            // cmd == CMD_PAUSE  :  Generate silence and enter PLAY_GAP_PAUSED
            // cmd == CMD_RESUME :  Do nothing
            // cmd == CMD_STOP   :  Generate 0 length sample and set finished to true
            // cmd == CMD_TERM   :  Generate 0 length sample and set finished to true            
            switch (cmd)
            {
            case CMD_NONE:
                if (gaps > 0)
                {
                    memset(frame->data, 0, AUDIO_FRAME_LENGTH * sizeof(uint32_t));
                    frame->length = AUDIO_FRAME_LENGTH;
                    audio_cbuf_finish_write();
                    if (i2s_buffer_underrun)    // If I2S buffer underrun occurred, resume sending
                        i2s_resume_playback();
                    --gaps;
                }
                else
                {
                    AUD_LOGD("Audio/core1: gap finished\n");
                    frame->length = 0;
                    audio_cbuf_finish_write();
                    if (i2s_buffer_underrun)    // If I2S buffer underrun occurred, resume sending
                        i2s_resume_playback();
                    finished = true;
                }
                break;
            case CMD_PAUSE:
                memset(frame->data, 0, AUDIO_FRAME_LENGTH * sizeof(uint32_t));
                frame->length = AUDIO_FRAME_LENGTH;
                audio_cbuf_finish_write();
                if (i2s_buffer_underrun)    // If I2S buffer underrun occurred, resume sending
                    i2s_resume_playback();
                --gaps;
                _playback.state = PLAY_GAP_PAUSED;
                break;
            case CMD_STOP:
                AUD_LOGD("Audio/core1: CMD_STOP\n");
                frame->length = 0;
                audio_cbuf_finish_write();
                if (i2s_buffer_underrun)    // If I2S buffer underrun occurred, resume sending
                    i2s_resume_playback();
                finished = true;
                break;
            case CMD_TERM:
                AUD_LOGD("Audio/core1: CMD_TERM\n");
                frame->length = 0;
                audio_cbuf_finish_write();
                if (i2s_buffer_underrun)    // If I2S buffer underrun occurred, resume sending
                    i2s_resume_playback();
                finished = true;
                break;
            }
            break;

        case PLAY_GAP_PAUSED:
            // PLAY_GAP:
            // cmd == CMD_NONE   :  Continue generate silence
            // cmd == CMD_PAUSE  :  Do nothing
            // cmd == CMD_RESUME :  Generate silence and enter PLAY_GAP
            // cmd == CMD_STOP   :  Generate 0 length sample and set finished to true
            // cmd == CMD_TERM   :  Generate 0 length sample and set finished to true
            switch (cmd)
            {
            case CMD_NONE:
                memset(frame->data, 0, AUDIO_FRAME_LENGTH * sizeof(uint32_t));
                frame->length = AUDIO_FRAME_LENGTH;
                audio_cbuf_finish_write();
                if (i2s_buffer_underrun)    // If I2S buffer underrun occurred, resume sending
                    i2s_resume_playback();
                break;
            case CMD_RESUME:
                memset(frame->data, 0, AUDIO_FRAME_LENGTH * sizeof(uint32_t));
                frame->length = AUDIO_FRAME_LENGTH;
                audio_cbuf_finish_write();
                if (i2s_buffer_underrun)    // If I2S buffer underrun occurred, resume sending
                    i2s_resume_playback();
                --gaps;
                _playback.state = PLAY_GAP;
                break;
            case CMD_STOP:
                AUD_LOGD("Audio/core1: CMD_STOP\n");
                frame->length = 0;
                audio_cbuf_finish_write();
                if (i2s_buffer_underrun)    // If I2S buffer underrun occurred, resume sending
                    i2s_resume_playback();
                finished = true;
                break;
            case CMD_TERM:
                AUD_LOGD("Audio/core1: CMD_TERM\n");
                frame->length = 0;
                audio_cbuf_finish_write();
                if (i2s_buffer_underrun)    // If I2S buffer underrun occurred, resume sending
                    i2s_resume_playback();
                finished = true;
                break;
            }
            break;

        }   // switch (_playback.state)
    }   // while (!finished)
    i2s_stop_playback();
    i2s_deinit();
    wm8978_mute(true);
    if (CMD_STOP == cmd) 
        EQ_QUICK_PUSH(EVT_AUDIO_SONG_TERMINATED);
    else if (CMD_TERM != cmd)
        EQ_QUICK_PUSH(EVT_AUDIO_SONG_FINISHED);
    multicore_fifo_push_blocking(0);    // audio_finish will wait for this
    AUD_LOGD("Audio/core1: playback exit\n");
}


void audio_start_playback(decoder_t *decoder)
{
    uint8_t cmd;
    AUD_LOGD("Audio/core0: start playback\n");
    _playback.decoder = decoder;
    bus_ctrl_hw->priority = BUSCTRL_BUS_PRIORITY_PROC1_BITS;        // bring up core1 bus priority
    multicore_reset_core1();
    multicore_launch_core1(playback_proc);
}


void audio_stop_playback()
{
    multicore_fifo_push_blocking(CMD_STOP);
    AUD_LOGD("Audio/core0: stop playback\n");
}


void audio_finish_playback()
{
    // Send CMD_TERM. If playback_proc already terminated, push a command into fifo won't do any harm.
    multicore_fifo_push_blocking(CMD_TERM);
    // playback_proc will always (regardless terminated via CMD_TERM or already terminiated) push 0 into fifo before exit
    multicore_fifo_pop_blocking();
    // Now playback_proc is finished
    multicore_reset_core1();
    _playback.decoder = NULL;
    _playback.state = PLAY_NONE;
    multicore_fifo_drain();
    AUD_LOGD("Audio/core0: finish playback\n");
}


void audio_pause_playback()
{
    multicore_fifo_push_blocking(CMD_PAUSE);
    AUD_LOGD("Audio/core0: pause playback\n");
}


void audio_resume_playback()
{
    multicore_fifo_push_blocking(CMD_RESUME);
    AUD_LOGD("Audio/core0: resume\n");
}


void audio_set_speaker_volume(int8_t vol)
{
    if (vol < 0) vol = 0;
    if (vol > 63) vol = 63;
    wm8978_set_volume(WM8978_OUTPUT_SPEAKER, (uint8_t)vol);
}


void audio_set_headphone_volume(int8_t vol)
{
    if (vol < 0) vol = 0;
    if (vol > 63) vol = 63;
    wm8978_set_volume(WM8978_OUTPUT_HEADPHONE, (uint8_t)vol);
}


/**
 * @brief Call this function repeatedly to receive jack detection notification
 * 
 * @param now       Timestamp
 * @return 0 if no change; 1 if headphone plugged; 2 if headphone unplugged;
 */
int audio_jack_detect(uint32_t now)
{
    int ret = 0;
    bool detected = gpio_get(JACK_DETECTION_PIN);   // JACK_DETECTION_PIN is high if inserted
    switch (_jack_state)
    {
    case JACK_EMPTY:
        if (detected)
        {
            _jack_timestamp = now;
            _jack_state = JACK_BOUNCING_IN;
        }
        break;
    case JACK_BOUNCING_IN:
        if (!detected)
        {
            _jack_state = JACK_EMPTY;
        }
        else if (now - _jack_timestamp >= JACK_DEBOUNCE_MS)
        {
            // jack plugged
            AUD_LOGI("Audio: headphone plugged @%d\n", now);
            ret = 1;
            _jack_state = JACK_INSERTED;
            EQ_QUICK_PUSH(EVT_HEADPHONE_PLUGGED);
        }
        break;
    case JACK_INSERTED:
        if (!detected)
        {
            _jack_timestamp = now;
            _jack_state = JACK_BOUNCING_OUT;
        }
        break;
    case JACK_BOUNCING_OUT:
        if (detected)
        {
            _jack_state= JACK_INSERTED;
        }
        else if (now - _jack_timestamp >= JACK_DEBOUNCE_MS)
        {
            // jack unplugged
            AUD_LOGI("Audio: headphone unplugged @%d\n", now);
            ret = 2;
            _jack_state = JACK_EMPTY;
            EQ_QUICK_PUSH(EVT_HEADPHONE_UNPLUGGED);
        }
        break;
    case JACK_NONE:
        // no break
    default:
        break;
    }
    return ret;
}


/**
 * @brief Get jack status
 * @return true if headphone plugged, false if headphone unplugged
 */
bool audio_get_jack_state()
{
    bool r = false;
    switch (_jack_state)
    {
    case JACK_INSERTED:
        // no break
    case JACK_BOUNCING_OUT:
        r = true;
        break;
    case JACK_EMPTY:
        // no break
    case JACK_BOUNCING_IN:
        // no break
    case JACK_NONE:
        // no break
    default:
        break;
    }
    return r;
}


void audio_jack_enable(bool enable)
{
    gpio_put(JACK_OUTEN_PIN, enable);
}
