baoshi/VGMPlayer/sw/main/modules/disk/sdcard_ll.c

/*
 * Low-level SPI-SDCARD interface
 * Lot has been borrowed from https://github.com/carlk3/no-OS-FatFS-SD-SPI-RPi-Pico
 * Credit Carl Kugler (carlk3@gmail.com)
 */

/* mbed Microcontroller Library
 * Copyright (c) 2006-2013 ARM Limited
 *
 * Licensed under the Apache License, Version 2.0 (the "License");
 * you may not use this file except in compliance with the License.
 * You may obtain a copy of the License at
 *
 *     http://www.apache.org/licenses/LICENSE-2.0
 *
 * Unless required by applicable law or agreed to in writing, software
 * distributed under the License is distributed on an "AS IS" BASIS,
 * WITHOUT WARRANTIES OR CONDITIONS OF ANY KIND, either express or implied.
 * See the License for the specific language governing permissions and
 * limitations under the License.
 */

/* Introduction
 * ------------
 * SD and MMC cards support a number of interfaces, but common to them all
 * is one based on SPI. Since we already have the mbed SPI Interface, it will
 * be used for SD cards.
 *
 * The main reference I'm using is Chapter 7, "SPI Mode" of:
 *  http://www.sdcard.org/developers/tech/sdcard/pls/Simplified_Physical_Layer_Spec.pdf
 *
 * SPI Startup
 * -----------
 * The SD card powers up in SD mode. The start-up procedure is complicated
 * by the requirement to support older SDCards in a backwards compatible
 * way with the new higher capacity variants SDHC and SDHC.
 *
 * The following figures from the specification with associated text describe
 * the SPI mode initialisation process:
 *  - Figure 7-1: SD Memory Card State Diagram (SPI mode)
 *  - Figure 7-2: SPI Mode Initialization Flow
 *
 * Firstly, a low initial clock should be selected (in the range of 100-
 * 400kHZ). After initialisation has been completed, the switch to a
 * higher clock speed can be made (e.g. 1MHz). Newer cards will support
 * higher speeds than the default _transfer_sck defined here.
 *
 * Next, note the following from the SDCard specification (note to
 * Figure 7-1):
 *
 *  In any of the cases CMD1 is not recommended because it may be difficult for
 * the host to distinguish between MultiMediaCard and SD Memory Card
 *
 * Hence CMD1 is not used for the initialisation sequence.
 *
 * The SPI interface mode is selected by asserting CS low and sending the
 * reset command (CMD0). The card will respond with a (R1) response.
 * In practice many cards initially respond with 0xff or invalid data
 * which is ignored. Data is read until a valid response is received
 * or the number of re-reads has exceeded a maximim count. If a valid
 * response is not received then the CMD0 can be retried. This
 * has been found to successfully initialise cards where the SPI master
 * (on MCU) has been reset but the SDCard has not, so the first
 * CMD0 may be lost.
 *
 * CMD8 is optionally sent to determine the voltage range supported, and
 * indirectly determine whether it is a version 1.x SD/non-SD card or
 * version 2.x. I'll just ignore this for now.
 *
 * ACMD41 is repeatedly issued to initialise the card, until "in idle"
 * (bit 0) of the R1 response goes to '0', indicating it is initialised.
 *
 * You should also indicate whether the host supports High Capicity cards,
 * and check whether the card is high capacity - i'll also ignore this
 *
 * SPI Protocol
 * ------------
 * The SD SPI protocol is based on transactions made up of 8-bit words, with
 * the host starting every bus transaction by asserting the CS signal low. The
 * card always responds to commands, data blocks and errors.
 *
 * The protocol supports a CRC, but by default it is off (except for the
 * first reset CMD0, where the CRC can just be pre-calculated, and CMD8)
 * I'll leave the CRC off I think!
 *
 * Standard capacity cards have variable data block sizes, whereas High
 * Capacity cards fix the size of data block to 512 bytes. I'll therefore
 * just always use the Standard Capacity cards with a block size of 512 bytes.
 * This is set with CMD16.
 *
 * You can read and write single blocks (CMD17, CMD25) or multiple blocks
 * (CMD18, CMD25). For simplicity, I'll just use single block accesses. When
 * the card gets a read command, it responds with a response token, and then
 * a data token or an error.
 *
 * SPI Command Format
 * ------------------
 * Commands are 6-bytes long, containing the command, 32-bit argument, and CRC.
 *
 * +---------------+------------+------------+-----------+----------+--------------+
 * | 01 | cmd[5:0] | arg[31:24] | arg[23:16] | arg[15:8] | arg[7:0] | crc[6:0] |
 * 1 |
 * +---------------+------------+------------+-----------+----------+--------------+
 *
 * As I'm not using CRC, I can fix that byte to what is needed for CMD0 (0x95)
 *
 * All Application Specific commands shall be preceded with APP_CMD (CMD55).
 *
 * SPI Response Format
 * -------------------
 * The main response format (R1) is a status byte (normally zero). Key flags:
 *  idle - 1 if the card is in an idle state/initialising
 *  cmd  - 1 if an illegal command code was detected
 *
 *    +-------------------------------------------------+
 * R1 | 0 | arg | addr | seq | crc | cmd | erase | idle |
 *    +-------------------------------------------------+
 *
 * R1b is the same, except it is followed by a busy signal (zeros) until
 * the first non-zero byte when it is ready again.
 *
 * Data Response Token
 * -------------------
 * Every data block written to the card is acknowledged by a byte
 * response token
 *
 * +----------------------+
 * | xxx | 0 | status | 1 |
 * +----------------------+
 *              010 - OK!
 *              101 - CRC Error
 *              110 - Write Error
 *
 * Single Block Read and Write
 * ---------------------------
 *
 * Block transfers have a byte header, followed by the data, followed
 * by a 16-bit CRC. In our case, the data will always be 512 bytes.
 *
 * +------+---------+---------+- -  - -+---------+-----------+----------+
 * | 0xFE | data[0] | data[1] |        | data[n] | crc[15:8] | crc[7:0] |
 * +------+---------+---------+- -  - -+---------+-----------+----------+
 */
#include <pico.h>
#include <pico/types.h>
#include <pico/time.h>
#include <hardware/gpio.h>
#include <hardware/dma.h>
#include <hardware/spi.h>

#include "crc.h"
#include "my_debug.h"
#include "hw_conf.h"
#include "sdcard_ll.h"


#ifndef SDCARD_DEBUG
# define SDCARD_DEBUG 0
#endif

// Debug log
#if SDCARD_DEBUG
#define SD_LOGD(x, ...)      MY_LOGD(x, ##__VA_ARGS__)
#define SD_LOGW(x, ...)      MY_LOGW(x, ##__VA_ARGS__)
#define SD_LOGE(x, ...)      MY_LOGE(x, ##__VA_ARGS__)
#define SD_LOGI(x, ...)      MY_LOGI(x, ##__VA_ARGS__)
#define SD_DEBUGF(x, ...)    MY_DEBUGF(x, ##__VA_ARGS__)
#else
#define SD_LOGD(x, ...)
#define SD_LOGW(x, ...)
#define SD_LOGE(x, ...)
#define SD_LOGI(x, ...)
#define SD_DEBUGF(x, ...)
#endif


#ifndef SD_SPI_FREQ
# define SD_SPI_FREQ (10000 * 1000)
#endif

#ifndef SD_SPI_INST
# define SD_SPI_INST SDCARD_SPI_INST
#endif

#ifndef SD_CLK_PIN
# define SD_CLK_PIN SDCARD_CLK_PIN
#endif

#ifndef SD_MOSI_PIN
# define SD_MOSI_PIN SDCARD_CMD_PIN
#endif

#ifndef SD_MISO_PIN
# define SD_MISO_PIN SDCARD_DAT0_PIN
#endif

#ifndef SD_SPI_CS_PIN
# define SD_SPI_CS_PIN SDCARD_DAT3_PIN
#endif

#ifndef SD_CD_PIN
# define SD_CD_PIN SDCARD_CD_PIN
#endif

#define SD_CRC_ENABLED                  1
#define SD_COMMAND_TIMEOUT              5000    // Timeout in ms for response
#define SD_CMD0_GO_IDLE_STATE_RETRIES   10

#define SPI_FILL_CHAR                   0xFF

/* Control Tokens   */
#define SPI_DATA_RESPONSE_MASK      (0x1F)
#define SPI_DATA_ACCEPTED           (0x05)
#define SPI_DATA_CRC_ERROR          (0x0B)
#define SPI_DATA_WRITE_ERROR        (0x0D)

#define SPI_START_BLOCK             (0xFE)      // For Single Block Read/Write and Multiple Block Read
#define SPI_START_BLK_MUL_WRITE     (0xFC)      // Start Multi-block write
#define SPI_STOP_TRAN               (0xFD)      // Stop Multi-block write

#define SPI_DATA_READ_ERROR_MASK    (0x0F)      // Data Error Token: 4 LSB bits
#define SPI_READ_ERROR              (0x01)      // Error
#define SPI_READ_ERROR_CC           (0x2)       // CC Error
#define SPI_READ_ERROR_ECC_C        (0x4)       // Card ECC failed
#define SPI_READ_ERROR_OFR          (0x8)       // Out of Range

/* R1 Response Format */
#define R1_NO_RESPONSE              (0xFF)
#define R1_RESPONSE_RECV            (0x80)
#define R1_IDLE_STATE               (0x01)
#define R1_ERASE_RESET              (0x02)
#define R1_ILLEGAL_COMMAND          (0x04)
#define R1_COM_CRC_ERROR            (0x08)
#define R1_ERASE_SEQUENCE_ERROR     (0x10)
#define R1_ADDRESS_ERROR            (0x20)
#define R1_PARAMETER_ERROR          (0x40)

/* R1b Response */
#define DEVICE_BUSY                 (0x00)

/* R2 Response Format */
#define R2_CARD_LOCKED          (1 << 0)
#define R2_CMD_FAILED           (1 << 1)
#define R2_ERROR                (1 << 2)
#define R2_CC_ERROR             (1 << 3)
#define R2_CC_FAILED            (1 << 4)
#define R2_WP_VIOLATION         (1 << 5)
#define R2_ERASE_PARAM          (1 << 6)
#define R2_OUT_OF_RANGE         (1 << 7)

/* R3 Response : OCR Register */
#define OCR_HCS_CCS             (0x1 << 30)
#define OCR_LOW_VOLTAGE         (0x01 << 24)
#define OCR_3_3V                (0x1 << 20)

/* R7 response pattern for CMD8 */
#define CMD8_PATTERN            (0xAA)

// Supported SD Card Commands
typedef enum 
{
    CMD_NOT_SUPPORTED               = -1,   // Command not supported error
    CMD0_GO_IDLE_STATE              = 0,    // Resets the SD Memory Card
    CMD1_SEND_OP_COND               = 1,    // Sends host capacity support 
    CMD6_SWITCH_FUNC                = 6,    // Check and Switches card function
    CMD8_SEND_IF_COND               = 8,    // Supply voltage info 
    CMD9_SEND_CSD                   = 9,    // Provides Card Specific data
    CMD10_SEND_CID                  = 10,   // Provides Card Identification
    CMD12_STOP_TRANSMISSION         = 12,   // Forces the card to stop transmission
    CMD13_SEND_STATUS               = 13,   // Card responds with status
    CMD16_SET_BLOCKLEN              = 16,   // Length for SC card is set
    CMD17_READ_SINGLE_BLOCK         = 17,   // Read single block of data
    CMD18_READ_MULTIPLE_BLOCK       = 18,   // Card transfers data blocks to host until interrupted by a STOP_TRANSMISSION command
    CMD24_WRITE_BLOCK               = 24,   // Write single block of data
    CMD25_WRITE_MULTIPLE_BLOCK      = 25,   // Continuously writes blocks of data until 'Stop Tran' token is sent
    CMD27_PROGRAM_CSD               = 27,   // Programming bits of CSD
    CMD32_ERASE_WR_BLK_START_ADDR   = 32,   // Sets the address of the first write block to be erased
    CMD33_ERASE_WR_BLK_END_ADDR     = 33,   // Sets the address of the last write block of the continuous range to be erased
    CMD38_ERASE                     = 38,   // Erases all previously selected write blocks
    CMD55_APP_CMD                   = 55,   // Extend to Applications specific commands
    CMD56_GEN_CMD                   = 56,   // General Purpose Command
    CMD58_READ_OCR                  = 58,   // Read OCR register of card
    CMD59_CRC_ON_OFF                = 59,   // Turns the CRC option on or off
    // App Commands = actual command + 128
    ACMD6_SET_BUS_WIDTH             = 6 + 128,
    ACMD13_SD_STATUS                = 13 + 128,
    ACMD22_SEND_NUM_WR_BLOCKS       = 22 + 128,
    ACMD23_SET_WR_BLK_ERASE_COUNT   = 23 + 128,
    ACMD41_SD_SEND_OP_COND          = 41 + 128,
    ACMD42_SET_CLR_CARD_DETECT      = 42 + 128,
    ACMD51_SEND_SCR                 = 51 + 128,
} sdcard_spi_cmd_t;

/* SIZE in Bytes */
#define PACKET_SIZE         6   // SD Packet size CMD+ARG+CRC
#define R1_RESPONSE_SIZE    1   // Size of R1 response
#define R2_RESPONSE_SIZE    2   // Size of R2 response
#define R3_R7_RESPONSE_SIZE 5   // Size of R3/R7 response

/* R3 Response : OCR Register */
#define OCR_HCS_CCS (0x1 << 30)
#define OCR_LOW_VOLTAGE (0x01 << 24)
#define OCR_3_3V (0x1 << 20)

#define SPI_CMD(x) (0x40 | (x & 0x3f))

static card_detect_cb_t _card_detect_cb = 0;
static void* _card_detect_cb_param = 0;

// SPI interface related variables
static dma_channel_config _spi_tx_dma_cfg, _spi_rx_dma_cfg;
static uint8_t _dummy = SPI_FILL_CHAR;
static bool _spi_initialized = false;

// Card related variables
static DSTATUS _sd_dstatus = STA_NODISK | STA_NOINIT;   // Card status, compatible with FatFs
static uint64_t _sd_sectors = 0;                        // Populated in sdcard_init
static int _sd_type = SDCARD_NONE;                      // Populated in sdcard_init


static void _spi_init()
{
    if (!_spi_initialized)
    {
        // Init SPI bus
        spi_init(SD_SPI_INST, 100 * 1000);   // Start 100kHz
        spi_set_format(SD_SPI_INST, 8, SPI_CPOL_0, SPI_CPHA_0, SPI_MSB_FIRST);
        gpio_set_function(SD_MOSI_PIN, GPIO_FUNC_SPI);
        gpio_set_function(SD_MISO_PIN, GPIO_FUNC_SPI);
        gpio_pull_up(SD_MISO_PIN);  // SD card DO must pull up
        gpio_set_function(SD_CLK_PIN, GPIO_FUNC_SPI);
        // Find unused DMA channels
        dma_channel_claim(DMA_CHANNEL_SDCARD_SPI_TX);
        dma_channel_claim(DMA_CHANNEL_SDCARD_SPI_RX);
        _spi_tx_dma_cfg = dma_channel_get_default_config(DMA_CHANNEL_SDCARD_SPI_TX);
        _spi_rx_dma_cfg = dma_channel_get_default_config(DMA_CHANNEL_SDCARD_SPI_RX);
        channel_config_set_transfer_data_size(&_spi_tx_dma_cfg, DMA_SIZE_8);
        channel_config_set_transfer_data_size(&_spi_rx_dma_cfg, DMA_SIZE_8);
        // TX DMA to transfer from a memory buffer to the SPI TX FIFO
        // paced by the SPI TX FIFO DREQ. Read address auto increase and
        // write address is fixed TX FIFO
        channel_config_set_dreq(&_spi_tx_dma_cfg, (spi_get_index(SD_SPI_INST) == 1) ? DREQ_SPI1_TX : DREQ_SPI0_TX);
        channel_config_set_read_increment(&_spi_tx_dma_cfg, true);
        channel_config_set_write_increment(&_spi_tx_dma_cfg, false);
        // RX DMA to transfer from the SPI RX FIFO to a memory buffer
        // paced by SPI RX FIFO DREQ. Read address is fixed and write
        // address auto increment
        channel_config_set_dreq(&_spi_rx_dma_cfg, (spi_get_index(SD_SPI_INST) == 1) ? DREQ_SPI1_RX : DREQ_SPI0_RX);
        channel_config_set_read_increment(&_spi_rx_dma_cfg, false);
        channel_config_set_write_increment(&_spi_rx_dma_cfg, true);
        _spi_initialized = true;
    }
}


static void _spi_deinit()
{
    if (_spi_initialized)
    {
        dma_channel_abort(DMA_CHANNEL_SDCARD_SPI_RX);
        dma_channel_abort(DMA_CHANNEL_SDCARD_SPI_TX);
        dma_channel_unclaim(DMA_CHANNEL_SDCARD_SPI_RX);
        dma_channel_unclaim(DMA_CHANNEL_SDCARD_SPI_TX);
        spi_deinit(SD_SPI_INST);
        gpio_put(SD_SPI_CS_PIN, true); // CS high
        _spi_initialized = false;
    }
}


static uint8_t _spi_xfer_byte(uint8_t value) 
{
    uint8_t received = SPI_FILL_CHAR;
    int num = spi_write_read_blocking(SD_SPI_INST, &value, &received, 1);
    MY_ASSERT(1 == num);
    return received;
}


// SPI Transfer: Read & Write (simultaneously) on SPI bus
// If the data that will be received is not important, pass NULL as rx.
// If the data that will be transmitted is not important, pass NULL as tx
// Data size is fixed SD_BLOCK_SIZE  
static bool _spi_xfer_bulk(const uint8_t *tx, uint8_t *rx) 
{
    const uint xfer_size = SD_BLOCK_SIZE;
    MY_ASSERT(tx || rx);  // either tx, or rx, or both
    if (tx) 
    {
        // If doing TX, read address shall increase
        channel_config_set_read_increment(&_spi_tx_dma_cfg, true);
    }
    else
    {
        // If not TX, sending dummy bytes
        _dummy = SPI_FILL_CHAR;
        tx = &_dummy;
        channel_config_set_read_increment(&_spi_tx_dma_cfg, false);
    }
    if (rx) 
    {
        // If doing RX, writing address shall increase
        channel_config_set_write_increment(&_spi_rx_dma_cfg, true);
    }
    else
    {
        // If not RX, receive into dummy location
        rx = &_dummy;
        channel_config_set_write_increment(&_spi_rx_dma_cfg, false);
    }
    dma_channel_configure(
        DMA_CHANNEL_SDCARD_SPI_TX,      // DMA channel
        &_spi_tx_dma_cfg,               // Pointer to channel config
        &spi_get_hw(SD_SPI_INST)->dr,   // write address
        tx,                             // read address
        xfer_size,                      // element count (each element is of size transfer_data_size (DMA_SIZE_8))
        false);                         // Not start yet
    dma_channel_configure(
        DMA_CHANNEL_SDCARD_SPI_RX,      // DMA channel
        &_spi_rx_dma_cfg,               // Pointer to channel config
        rx,                             // write address
        &spi_get_hw(SD_SPI_INST)->dr,   // read address
        xfer_size,                      // element count (each element is of size transfer_data_size (DMA_SIZE_8))
        false);                         // Not start yet
    // start them exactly simultaneously to avoid races (in extreme cases the FIFO could overflow)
    dma_start_channel_mask((1u << DMA_CHANNEL_SDCARD_SPI_RX) | (1u << DMA_CHANNEL_SDCARD_SPI_TX));
    // Wait finish. Using DMA is faster than spi_write_read_blocking.
    dma_channel_wait_for_finish_blocking(DMA_CHANNEL_SDCARD_SPI_TX);
    dma_channel_wait_for_finish_blocking(DMA_CHANNEL_SDCARD_SPI_RX);
    MY_ASSERT(!dma_channel_is_busy(DMA_CHANNEL_SDCARD_SPI_TX));
    MY_ASSERT(!dma_channel_is_busy(DMA_CHANNEL_SDCARD_SPI_RX));
    return true;
}


static void _spi_set_high_freq() 
{
    uint actual = spi_set_baudrate(SD_SPI_INST, SD_SPI_FREQ);
    SD_LOGD("SPI frequency: %lu\n", (long)actual);
}


static void _spi_set_low_freq()
{
    uint actual = spi_set_baudrate(SD_SPI_INST, 100 * 1000);
    SD_LOGD("SPI frequency: %lu\n", (long)actual);
}


static void _spi_set_cs_low()
{
    _dummy = SPI_FILL_CHAR;
    spi_write_blocking(SD_SPI_INST, &_dummy, 1); 
    gpio_put(SD_SPI_CS_PIN, false);
}


static void _spi_set_cs_high()
{
    _dummy = SPI_FILL_CHAR;
    gpio_put(SD_SPI_CS_PIN, true);
    /*
    MMC/SDC enables/disables the DO output in synchronising to the SCLK. This
    means there is a posibility of bus conflict with MMC/SDC and another SPI
    slave that shares an SPI bus. Therefore to make MMC/SDC release the MISO
    line, the master device needs to send a dummy byte after the CS signal is
    deasserted.
    Not needed if SPI bus is not shared
    */
    spi_write_blocking(SD_SPI_INST, &_dummy, 1);
}


static uint8_t _spi_send_cmd(sdcard_spi_cmd_t cmd, uint32_t arg) 
{
    uint8_t response;
    char packet[PACKET_SIZE];
    // Prepare command packet
    packet[0] = SPI_CMD(cmd);
    packet[1] = (arg >> 24);
    packet[2] = (arg >> 16);
    packet[3] = (arg >> 8);
    packet[4] = (arg >> 0);
#if SD_CRC_ENABLED
    packet[5] = (crc7(packet, 5) << 1) | 0x01;
#else
    // CMD0 is executed in SD mode, hence should have correct CRC
    // CMD8 CRC verification is always enabled
    switch (cmd) 
    {
        case CMD0_GO_IDLE_STATE:
            packet[5] = 0x95;   // pre-calculated
            break;
        case CMD8_SEND_IF_COND:
            packet[5] = 0x87;   // pre-calculated
            break;
        default:
            packet[5] = 0xFF;  // Make sure bit 0-End bit is high
            break;
    }
#endif
    // send a command
    for (int i = 0; i < PACKET_SIZE; i++) 
    {
        _spi_xfer_byte(packet[i]);
    }
    // The received byte immediataly following CMD12 is a stuff byte,
    // it should be discarded before receive the response of the CMD12.
    if (CMD12_STOP_TRANSMISSION == cmd)
    {
        _spi_xfer_byte(SPI_FILL_CHAR);
    }
    // Loop for response: Response is sent back within command response time
    // (NCR), 0 to 8 bytes for SDC
    for (int i = 0; i < 0x10; i++)
    {
        response = _spi_xfer_byte(SPI_FILL_CHAR);
        // Got the response
        if (!(response & R1_RESPONSE_RECV))
        {
            break;
        }
    }
    // Card DO has pull up. response == 0xFF if no response
    return response;
}


static bool _sd_wait_ready(int timeout) 
{
    bool ret = false;
    uint8_t response;
    // Keep sending dummy clocks with DI held high until the card releases the DO line (DO all high)
    absolute_time_t timeout_time = make_timeout_time_ms(timeout);
    do 
    {
        response = _spi_xfer_byte(0xFF);
        if (response == 0xFF)
        {
            ret = true;
            break;
        }
    } while (0 < absolute_time_diff_us(get_absolute_time(), timeout_time));
    return ret;
}


static int _sd_cmd(sdcard_spi_cmd_t cmd, uint32_t arg, bool need_cs, uint32_t *resp) 
{
    int32_t status = SDCARD_ERROR_OK;
    uint32_t response;

    if (need_cs)
    {
        _spi_set_cs_low();
    }

    // If we're sending CMD12_STOP_TRANSMISSION, don't wait for IDLE
    if (CMD12_STOP_TRANSMISSION != cmd) 
    {
        if (false == _sd_wait_ready(SD_COMMAND_TIMEOUT)) 
        {
            SD_LOGW("%s:%d Card not ready when sending CMD:%02d\n", __FILE__, __LINE__, cmd);
            // We will still try send command
        }
    }
    // Re-try command
    for (int i = 0; i < 3; i++) 
    {
        // Send CMD55 first for APP command. App cmd > 128
        if (cmd & 0x80) 
        {
            response = _spi_send_cmd(CMD55_APP_CMD, 0x00);
            // Wait for card to be ready after CMD55
            if (false == _sd_wait_ready(SD_COMMAND_TIMEOUT)) 
            {
                SD_LOGW("%s:%d Card not ready before sending APP CMD:%02d\n", __FILE__, __LINE__, cmd);
            }
        }
        // Send command
        response = _spi_send_cmd(cmd, arg);
        // Move on if we have response, otherwise retry
        if (R1_NO_RESPONSE != response) 
        {
            break;
        }
    }
    // Pass the response to the command call if required
    if (NULL != resp) 
    {
        *resp = response;
    }
    // Fatal cases: CRC/Illegal command error/No response
    if (R1_NO_RESPONSE == response)     // retry fails
    {
        SD_LOGW("%s:%d No response for CMD:%02d\n", __FILE__, __LINE__, cmd);
        status = SDCARD_ERROR_NO_DEVICE;  // No device
        goto exit;
    }
    if (response & R1_COM_CRC_ERROR)
    {
        SD_LOGW("%s:%d CRC error for CMD:%02d, Response 0x%08x\n", __FILE__, __LINE__, cmd, response);
        status = SDCARD_ERROR_CRC;  // CRC error
        goto exit;
    }
    if (response & R1_ILLEGAL_COMMAND) 
    {
        if (ACMD23_SET_WR_BLK_ERASE_COUNT != cmd)
        {
            SD_LOGW("%s:%d Illegal CMD:%02d, Response 0x%08x\n", __FILE__, __LINE__, cmd & 0x7f, response);
        }
        if (CMD8_SEND_IF_COND == cmd)       // V1 card does not support CMD8_SEND_IF_COND
        {
            _sd_type = CARD_UNKNOWN;
        }
        status = SDCARD_ERROR_UNSUPPORTED;  // Command not supported
        goto exit;
    }
    // Non-fatal cases
    SD_LOGD("CMD:%02d arg:0x%08x, Response:0x%08x\n", cmd, arg, response);
    if ((response & R1_ERASE_RESET) || (response & R1_ERASE_SEQUENCE_ERROR))
    {
        status = SDCARD_ERROR_ERASE;        // Erase error
    }
    else if ((response & R1_ADDRESS_ERROR) || (response & R1_PARAMETER_ERROR)) 
    {
        status = SDCARD_ERROR_PARAMETER;    // Misaligned address / invalid address block length
    }
    // Get rest of the response for specific commands
    switch (cmd) 
    {
        case CMD8_SEND_IF_COND:  // Response R7
            _sd_type = SDCARD_V2;
            response  = (_spi_xfer_byte(SPI_FILL_CHAR) << 24);
            response |= (_spi_xfer_byte(SPI_FILL_CHAR) << 16);
            response |= (_spi_xfer_byte(SPI_FILL_CHAR) << 8);
            response |= _spi_xfer_byte(SPI_FILL_CHAR);
            SD_LOGD("R7: 0x%08x, detected V2 card\n", response);
            break;

        case CMD58_READ_OCR:  // Response R3
            response  = (_spi_xfer_byte(SPI_FILL_CHAR) << 24);
            response |= (_spi_xfer_byte(SPI_FILL_CHAR) << 16);
            response |= (_spi_xfer_byte(SPI_FILL_CHAR) << 8);
            response |= _spi_xfer_byte(SPI_FILL_CHAR);
            SD_LOGD("R3: 0x%08x\n", response);
            break;

        case CMD12_STOP_TRANSMISSION:  // Response R1b
        case CMD38_ERASE:
            _sd_wait_ready(SD_COMMAND_TIMEOUT);
            break;

        case ACMD13_SD_STATUS:  // Response R2
            response = _spi_xfer_byte(SPI_FILL_CHAR);
            SD_LOGD("R2: 0x%08x\n", response);
            break;

        default:  // Response R1
            break;
    }
    // Pass the updated response to the command
    if (NULL != resp) 
    {
        *resp = response;
    }
exit:
    if (need_cs)
    {
        _spi_set_cs_high();
    }
    return status;
}


static uint32_t _sd_go_idle_state()
{
    uint32_t response;
    /* Resetting the MCU SPI master may not reset the on-board SDCard, in which
     * case when MCU power-on occurs the SDCard will resume operations as
     * though there was no reset. In this scenario the first CMD0 will
     * not be interpreted as a command and get lost. For some cards retrying
     * the command overcomes this situation. 
     */
    for (int i = 0; i < SD_CMD0_GO_IDLE_STATE_RETRIES; ++i)
    {
        _sd_cmd(CMD0_GO_IDLE_STATE, 0x0, true, &response);
        if (R1_IDLE_STATE == response) 
        {
            break;
        }
        _spi_set_cs_high();
        busy_wait_ms(100);
        _spi_set_cs_low();
    }
    return response;
}


static int _sd_init_card()
{
    int32_t status = SDCARD_ERROR_OK;
    uint32_t response, arg;

    _spi_set_low_freq();

    // The card is transitioned from SDCard mode to SPI mode by sending the CMD0 + CS Asserted("0")
    if (_sd_go_idle_state() != R1_IDLE_STATE) 
    {
        SD_LOGW("%s:%d No disk, or could not put SD card into SPI idle state\n", __FILE__, __LINE__);
        status = SDCARD_ERROR_NO_DEVICE;
        goto exit;
    }

    // Assume V2 card and verify voltage and pattern by sending CMD8
    arg = CMD8_PATTERN;         // [7:0] check pattern
    arg |= (0x1 << 8);          // [11:8] supply voltage(VHS) 2.7-3.6V 
    status = _sd_cmd(CMD8_SEND_IF_COND, arg, true, &response);
    if ((SDCARD_ERROR_OK == status) && (SDCARD_V2 == _sd_type)) 
    {
        // If check pattern is not matched, CMD8 communication is not valid
        if ((response & 0xFFF) != arg) 
        {
            SD_LOGW("%s:%d CMD8 Pattern mismatch 0x%08x : 0x%08x\n", __FILE__, __LINE__, arg, response);
            _sd_type = CARD_UNKNOWN;
            status = SDCARD_ERROR_UNUSABLE;
        }
    }
    // If the card rejects the CMD8 then it's probably using the v1 protocol, or is a MMC, or just flat-out broken
    if ((SDCARD_ERROR_OK != status) && (SDCARD_ERROR_UNSUPPORTED != status))
    {
        goto exit;
    }

#if SD_CRC_ENABLED
    // Enable CRC
    status = _sd_cmd(CMD59_CRC_ON_OFF, 0x01, true, NULL);
#endif

    // Read OCR - CMD58 Response contains OCR register
    status = _sd_cmd(CMD58_READ_OCR, 0x0, true, &response);
    if (SDCARD_ERROR_OK != status) 
    {
        goto exit;
    }
    // Check if card supports voltage range: 3.3V
    if (!(response & OCR_3_3V)) 
    {
        _sd_type = CARD_UNKNOWN;
        status = SDCARD_ERROR_UNUSABLE;
        goto exit;
    }

    // HCS is set to 1 for HC/XC cards for ACMD41, if supported
    arg = 0x0;
    if (SDCARD_V2 == _sd_type) 
    {
        arg |= OCR_HCS_CCS;
    }
    /* Idle state bit in the R1 response of ACMD41 is used by the card to inform
     * the host if initialization of ACMD41 is completed. "1" indicates that the
     * card is still initializing. "0" indicates completion of initialization.
     * The host repeatedly issues ACMD41 until this bit is set to "0".
     */
    absolute_time_t timeout_time = make_timeout_time_ms(SD_COMMAND_TIMEOUT);
    do 
    {
        status = _sd_cmd(ACMD41_SD_SEND_OP_COND, arg, true, &response);
        if ((response & R1_IDLE_STATE) == 0)
        {
            break;
        }
        sleep_ms(10);
    } while (0 < absolute_time_diff_us(get_absolute_time(), timeout_time));
    // Initialization complete, ACMD41 successful, or timeout
    if ((SDCARD_ERROR_OK != status) || (0x00 != response))
    {
        _sd_type = CARD_UNKNOWN;
        status = SDCARD_ERROR_NO_RESPONSE;
        SD_LOGW("%s:%d Timeout waiting for card to initialize\n", __FILE__, __LINE__);
        goto exit;
    }

    if (SDCARD_V2 == _sd_type) 
    {
        // Get the card capacity CCS: CMD58
        status = _sd_cmd(CMD58_READ_OCR, 0x0, true, &response);
        if (SDCARD_ERROR_OK == status)
        {
            // High Capacity card
            if (response & OCR_HCS_CCS)
            {
                _sd_type = SDCARD_V2HC;
                SD_LOGD("Card Initialized: High Capacity Card\n");
            }
            else
            {
                SD_LOGD("Card Initialized: Standard Capacity Card: Version 2.x\n");
            }
        }
        else
        {
            SD_LOGW("CMD58 failed.\n");
        }
    }
    else 
    {
        _sd_type = SDCARD_V1;
        SD_LOGD("Card Initialized: Version 1.x Card\n");
    }

#if !(SD_CRC_ENABLED)
    // Disable CRC
    status = _sd_cmd(CMD59_CRC_ON_OFF, 0, true, NULL);
#endif

exit:
    return status;
}


// Function to wait till chip is ready and sends start token (no CS)
static bool _sd_wait_token(uint8_t token) 
{
    const uint32_t timeout = SD_COMMAND_TIMEOUT;  // Wait for start token
    absolute_time_t timeout_time = make_timeout_time_ms(timeout);
    do 
    {
        if (token == _spi_xfer_byte(SPI_FILL_CHAR)) 
        {
            return true;
        }
    } while (0 < absolute_time_diff_us(get_absolute_time(), timeout_time));
    return false;
}


// Function to read certain bytes from card (no CS)
static int _sd_read_bytes(uint8_t *buffer, uint32_t length) 
{
    uint16_t crc;
    // read until start byte (0xFE)
    if (false == _sd_wait_token(SPI_START_BLOCK)) 
    {
        SD_LOGW("%s:%d Read timeout\n", __FILE__, __LINE__);
        return SDCARD_ERROR_NO_RESPONSE;
    }
    // read data
    for (uint32_t i = 0; i < length; i++) 
    {
        buffer[i] = _spi_xfer_byte(SPI_FILL_CHAR);
    }
    // Read the CRC16 checksum for the data block
    crc = (_spi_xfer_byte(SPI_FILL_CHAR) << 8);
    crc |= _spi_xfer_byte(SPI_FILL_CHAR);

#if SD_CRC_ENABLED
    uint32_t crc_result;
    // Compute and verify checksum
    crc_result = crc16((void *)buffer, length);
    if ((uint16_t)crc_result != crc) 
    {
        SD_LOGW("%s:%d Invalid CRC received 0x%04x, result of computation 0x%04x\n", __FILE__, __LINE__, crc, (uint16_t)crc_result);
        return SDCARD_ERROR_CRC;
    }
#endif

    return SDCARD_ERROR_OK;
}


// Read one block. Block size is SD_BLOCK_SIZE (no CS)
static int _sd_read_block(uint8_t *buffer) 
{
    uint16_t crc;

    // read until start byte (0xFE)
    if (false == _sd_wait_token(SPI_START_BLOCK)) 
    {
        SD_LOGW("%s:%d Read timeout\n", __FILE__, __LINE__);
        return SDCARD_ERROR_NO_RESPONSE;
    }
    // read data
    if (!_spi_xfer_bulk(NULL, buffer))
    {
        return SDCARD_ERROR_NO_RESPONSE;
    }
    // Read the CRC16 checksum for the data block
    crc = (_spi_xfer_byte(SPI_FILL_CHAR) << 8);
    crc |= _spi_xfer_byte(SPI_FILL_CHAR);

#if SD_CRC_ENABLED
    uint32_t crc_result;
    // Compute and verify checksum
    crc_result = crc16((void *)buffer, SD_BLOCK_SIZE);
    if ((uint16_t)crc_result != crc) 
    {
        SD_LOGW("%s:%d Invalid CRC received 0x%04x, result of computation 0x%04x\n", __FILE__, __LINE__, crc, (uint16_t)crc_result);
        return SDCARD_ERROR_CRC;
    }
#endif

    return SDCARD_ERROR_OK;
}


// Write one block. Block size is SD_BLOCK_SIZE
static uint8_t _sd_write_block(const uint8_t *buffer, uint8_t token) 
{
    uint16_t crc = 0xFFFF;
    uint8_t response = 0xFF;

    // indicate start of block
    _spi_xfer_byte(token);

    // write the data
    bool ret = _spi_xfer_bulk(buffer, NULL);
    MY_ASSERT(ret);

#if SD_CRC_ENABLED
    crc = crc16((void *)buffer, SD_BLOCK_SIZE);
#endif

    // write the checksum CRC16
    _spi_xfer_byte(crc >> 8);
    _spi_xfer_byte(crc);

    // check the response token
    response = _spi_xfer_byte(SPI_FILL_CHAR);

    // Wait for last block to be written
    if (false == _sd_wait_ready(SD_COMMAND_TIMEOUT)) 
    {
        SD_LOGW("%s:%d: Card not ready\n", __FILE__, __LINE__);
    }
    return (response & SPI_DATA_RESPONSE_MASK);
}


// From data array, extract bits ranging [msb:lsb], flush to right and return
static uint32_t _ext_bits(unsigned char *data, int msb, int lsb) 
{
    uint32_t bits = 0;
    uint32_t size = 1 + msb - lsb;
    for (uint32_t i = 0; i < size; i++) 
    {
        uint32_t position = lsb + i;
        uint32_t byte = 15 - (position >> 3);
        uint32_t bit = position & 0x7;
        uint32_t value = (data[byte] >> bit) & 1;
        bits |= value << i;
    }
    return bits;
}


static uint64_t _sd_get_sectors()
{
    uint32_t c_size, c_size_mult, read_bl_len;
    uint32_t block_len, mult, blocknr;
    uint32_t hc_c_size;
    uint64_t blocks = 0, capacity = 0;

    _spi_set_cs_low();

    // CMD9, Response R2 (R1 byte + 16-byte block read)
    if (SDCARD_ERROR_OK != _sd_cmd(CMD9_SEND_CSD, 0x0, false, NULL)) 
    {
        SD_LOGW("%s:%d Didn't get a response from the disk\n", __FILE__, __LINE__);
        goto exit;
    }
    uint8_t csd[16];
    if (SDCARD_ERROR_OK != _sd_read_bytes(csd, 16)) 
    {
        SD_LOGW("%s:%d Couldn't read csd response from disk\n", __FILE__, __LINE__);
        goto exit;
    }
    // csd_structure : csd[127:126]
    int csd_structure = _ext_bits(csd, 127, 126);
    switch (csd_structure) 
    {
        case 0: // CSD Version 1.0
            c_size = _ext_bits(csd, 73, 62);            // c_size        : csd[73:62]
            c_size_mult = _ext_bits(csd, 49, 47);       // c_size_mult   : csd[49:47]
            read_bl_len = _ext_bits(csd, 83, 80);       // read_bl_len   : csd[83:80] - the *maximum* read block length
            block_len = 1 << read_bl_len;               // BLOCK_LEN = 2^READ_BL_LEN
            mult = 1 << (c_size_mult + 2);              // MULT = 2^(C_SIZE_MULT+2)
            blocknr = (c_size + 1) * mult;              // BLOCKNR = (C_SIZE+1) * MULT
            capacity = (uint64_t)blocknr * block_len;   // memory capacity = BLOCKNR * BLOCK_LEN
            blocks = capacity / SD_BLOCK_SIZE;
            SD_LOGI("Standard Capacity: c_size: %lu\n", c_size);
            SD_LOGI("Sectors: %llu\n", blocks);
            SD_LOGI("Capacity: %llu MB\n", (capacity / (1024U * 1024U)));
            break;

        case 1: // CSD Version 2.0
            hc_c_size = _ext_bits(csd, 69, 48);          // device size : C_SIZE : [69:48]
            blocks = (hc_c_size + 1) << 10;              // block count = (C_SIZE+1) * 1K byte (512B is block size)
            SD_LOGI("SDHC/SDXC Card: hc_c_size: %lu\n", hc_c_size);
            SD_LOGI("Sectors: %llu\n", blocks);
            SD_LOGI("Capacity: %llu MB\n", (blocks / (2048U)));
            break;

        case 2: // // CSD Version 3.0 (SDUC) not supported
        default:    
            SD_LOGW("CSD struct unsupported\n");
            return 0;
    };

exit:
    _spi_set_cs_high();
    return blocks;
}


// Called from sdcard_fatfs_io.c
int sdcard_init()
{
    MY_ASSERT(_spi_initialized);
    // Make sure there's a card in the socket before proceeding
    if (gpio_get(SD_CD_PIN))    // CD has internal pullup
    {
        _sd_dstatus = STA_NODISK | STA_NOINIT;
        goto exit;
    }
    _sd_dstatus &= ~STA_NODISK;
    
    // Make sure card is not already initialized
    if (!(_sd_dstatus & STA_NOINIT)) 
    {
        SD_LOGW("SD card already initialized\n");
        goto exit;
    }

    // Query card type
    _sd_type = SDCARD_NONE;
    int err = _sd_init_card();
    if (SDCARD_ERROR_OK != err) 
    {
        SD_LOGW("Failed to initialize card\n");
        goto exit;
    }
    SD_LOGI("SD card initialized\n");

    // Query size
    _sd_sectors = _sd_get_sectors();    
    if (0 == _sd_sectors) 
    {
        SD_LOGW("Failed to get card size\n");
        goto exit;
    }
    
    // Set block length to 512 (CMD16)
    int ret = _sd_cmd(CMD16_SET_BLOCKLEN, SD_BLOCK_SIZE,true, NULL);
    if (SDCARD_ERROR_OK != ret)
    {
        SD_LOGW("Set %d-bytes per block timed out\n", SD_BLOCK_SIZE);
        goto exit;
    }

    // Set SCK for data transfer
    _spi_set_high_freq();
    
    // The card is now initialized
    _sd_dstatus &= ~STA_NOINIT;

exit:
    return _sd_dstatus;
}


/** Read blocks
 *  @param buffer   Buffer to receive results
 *  @param start    Start block
 *  @param count    Number of blocks
 *  @return         Error code
 */
int sdcard_read_blocks(uint8_t *buffer, uint64_t start, uint32_t count) 
{
    SD_LOGD("SD: read %d blocks\n", count)
    int status = SDCARD_ERROR_OK;
    uint32_t blocks = count;

    if (start + blocks > _sd_sectors)
    {
        status = SDCARD_ERROR_PARAMETER;
        goto exit;
    }
    if (_sd_dstatus & STA_NODISK)
    {
        status = SDCARD_ERROR_NO_DEVICE;
        goto exit;
    }

    if (_sd_dstatus & STA_NOINIT)
    {
        status = SDCARD_ERROR_NO_INIT;
        goto exit;
    }

    uint64_t addr;
    // SDSC Card (CCS=0) uses byte unit address
    // SDHC and SDXC Cards (CCS=1) use block unit address (512 Bytes unit)
    if (SDCARD_V2HC == _sd_type)
    {
        addr = start;
    }
    else 
    {
        addr = start * SD_BLOCK_SIZE;
    }

    // Write command to receive data

    _spi_set_cs_low();

    int rstatus = SDCARD_ERROR_OK;
    if (blocks > 1) 
    {
        rstatus = _sd_cmd(CMD18_READ_MULTIPLE_BLOCK, addr, false, NULL);
    }
    else
    {
        rstatus = _sd_cmd(CMD17_READ_SINGLE_BLOCK, addr, false, NULL);
    }
    if (SDCARD_ERROR_OK != rstatus) 
    {
        status = rstatus;
        goto exit;
    }
    // receive the data, one block at a time
    while (blocks) 
    {
        if (SDCARD_ERROR_OK != _sd_read_block(buffer)) 
        {
            status = SDCARD_ERROR_NO_RESPONSE;
            break;
        }
        buffer += SD_BLOCK_SIZE;
        --blocks;
    }
    // Send CMD12(0x00000000) to stop the transmission for multi-block transfer
    if (count > 1)
    {
        rstatus = _sd_cmd(CMD12_STOP_TRANSMISSION, 0x0, false, NULL);
    }
    if (SDCARD_ERROR_OK == status)  // Always get the worst result
    {
        status = rstatus;
    }

exit:
    _spi_set_cs_high(); // doesn't matter if it is already high
    return status;
}


/** Write blocks
 *  @param buffer   Buffer of data to write to blocks
 *  @param start    Start block
 *  @param count    Number of blocks
 *  @return         Error code
 */
int sdcard_write_blocks(const uint8_t *buffer, uint64_t start, uint32_t count) 
{
    int status = SDCARD_ERROR_OK;
    if (start + count > _sd_sectors)
    {
        status = SDCARD_ERROR_PARAMETER;
        goto exit;
    }

    if (_sd_dstatus & STA_NODISK)
    {
        status = SDCARD_ERROR_NO_DEVICE;
        goto exit;
    }

    if (_sd_dstatus & STA_NOINIT)
    {
        status = SDCARD_ERROR_NO_INIT;
        goto exit;
    }

    uint8_t response;
    uint64_t addr;

    // SDSC Card (CCS=0) uses byte unit address
    // SDHC and SDXC Cards (CCS=1) use block unit address (512 Bytes unit)
    if (SDCARD_V2HC == _sd_type) 
    {
        addr = start;
    }
    else
    {
        addr = start * SD_BLOCK_SIZE;
    }

    // Send command to perform write operation
    
    _spi_set_cs_low();

    if (count == 1)  // Single block write command
    {
        status = _sd_cmd(CMD24_WRITE_BLOCK, addr, false, NULL);
        if (SDCARD_ERROR_OK != status)
        {
            goto exit;
        }
        // Write data
        response = _sd_write_block(buffer, SPI_START_BLOCK);
        // Only CRC and general write error are communicated via response token
        if (response != SPI_DATA_ACCEPTED) 
        {
            SD_LOGW("%s:%d: Single Block Write failed: 0x%x\n", __FILE__, __LINE__, response);
            status = SDCARD_ERROR_WRITE;
        }
    }
    else    // Multiple blocks write command
    {
        // Pre-erase setting prior to multiple block write operation
        _sd_cmd(ACMD23_SET_WR_BLK_ERASE_COUNT, count, false, NULL);
        // Multiple block write command
        status = _sd_cmd(CMD25_WRITE_MULTIPLE_BLOCK, addr, false, NULL);
        if (SDCARD_ERROR_OK != status)
        {
            goto exit;
        }
        // Write the data: one block at a time
        do 
        {
            response = _sd_write_block(buffer, SPI_START_BLK_MUL_WRITE);
            if (response != SPI_DATA_ACCEPTED) 
            {
                SD_LOGW("%s:%d Multiple Block Write failed: 0x%x\n", __FILE__, __LINE__, response);
                status = SDCARD_ERROR_WRITE;
                break;
            }
            buffer += SD_BLOCK_SIZE;
        } while (--count);  // Send all blocks of data
        /* In a Multiple Block write operation, the stop transmission will be
         * done by sending 'Stop Tran' token instead of 'Start Block' token at
         * the beginning of the next block
         */
        _spi_xfer_byte(SPI_STOP_TRAN);
    }

exit:
    _spi_set_cs_high();
    return status;
}


DSTATUS sdcard_get_dstatus()
{
    return _sd_dstatus;
}


int64_t sdcard_get_sectors()
{
    return _sd_sectors;
}


// SD card low level driver interface
// Initailly, we assume no card present, only card detection pin is initialized.
// Caller will repeatedly call sdcard_ll_card_detect().
// Inside sdcard_ll_card_detect, we check card detect pin (with debounce).
// Once card detected, SPI bus is initailized, and card_detect_cb is called.
// The callback is where caller can initailize FATFS.
// When card ejected, card_detect_cb is called again then SPI bus deinitialized.

// Card detection fsm
#define CARD_INSERTION_DELAY_MS 100
static uint32_t _card_timestamp = 0;
static enum 
{
    CARD_EMPTY,
    CARD_BOUNCING,
    CARD_INSERTED
} _card_state;


void sdcard_ll_init(card_detect_cb_t callback, void* param)
{
    // Init card CS pin and keep it high
    gpio_init(SD_SPI_CS_PIN);
    gpio_put(SD_SPI_CS_PIN, true);
    gpio_set_dir(SD_SPI_CS_PIN, GPIO_OUT);
    gpio_put(SD_SPI_CS_PIN, true);  // In case glitch
    // Init card detect pin
    gpio_init(SD_CD_PIN);
    gpio_pull_up(SD_CD_PIN);
    gpio_set_dir(SD_CD_PIN, GPIO_IN);
    _sd_dstatus = STA_NODISK | STA_NOINIT;  // disk status
    _sd_sectors = 0;
    _sd_type = SDCARD_NONE;
    _spi_initialized = false;
    _card_detect_cb = callback;
    _card_detect_cb_param = param;
    _card_state = CARD_EMPTY;
    _card_timestamp = 0;

}


/**
 * @brief Call this function repeatedly to receive card insert/eject notification
 * 
 * @param now       Timestamp
 * @return 0 if no change to card; 1 if card inserted; 2 if card ejected
 *
 */
int sdcard_ll_card_detect(uint32_t now)
{
    int ret = 0;
    bool detected = !gpio_get(SD_CD_PIN);   // SD_CD_PIN low is card detected
    switch (_card_state)
    {
    case CARD_EMPTY:
        if (detected)
        {
            _card_timestamp = now;
            _card_state = CARD_BOUNCING;
        }
        break;
    case CARD_BOUNCING:
        if (!detected)
        {
            _card_state = CARD_EMPTY;
        }
        else if (now - _card_timestamp >= CARD_INSERTION_DELAY_MS)
        {
            // card inserted
            SD_LOGI("SD card inserted\n");
            ret = 1;
            _spi_init();
            _sd_dstatus &= ~STA_NODISK;
            if (_card_detect_cb) _card_detect_cb(true, _card_detect_cb_param);
            _card_state = CARD_INSERTED;
        }
        break;
    case CARD_INSERTED:
        if (!detected)
        {
            // no debounce here !
            SD_LOGI("SD card removed\n");
            ret = 2;
            if (_card_detect_cb) _card_detect_cb(false, _card_detect_cb_param);
            _spi_deinit();
            _sd_dstatus |= (STA_NODISK | STA_NOINIT);
            _sd_type = SDCARD_NONE;
            gpio_put(SD_SPI_CS_PIN, true);  // Put CS high
            _card_state = CARD_EMPTY;
        }
        break;
    default:
        break;
    }
    return ret;
}


bool sdcard_ll_card_detected()
{
    bool r = false;
    switch (_card_state)
    {
    case CARD_INSERTED:
        r = true;
        break;
    case CARD_EMPTY:
        // no break
    case CARD_BOUNCING:
        // no break
    default:
        break;
    }
    return r;
}
