baoshi/VGMPlayer/sw/main/modules/display/img_browser_file_raw.c

#if defined(LV_LVGL_H_INCLUDE_SIMPLE)
#include "lvgl.h"
#else
#include "lvgl/lvgl.h"
#endif


#ifndef LV_ATTRIBUTE_MEM_ALIGN
#define LV_ATTRIBUTE_MEM_ALIGN
#endif

#ifndef LV_ATTRIBUTE_IMG_IMG_BROWSER_FILE_RAW
#define LV_ATTRIBUTE_IMG_IMG_BROWSER_FILE_RAW
#endif

const LV_ATTRIBUTE_MEM_ALIGN LV_ATTRIBUTE_LARGE_CONST LV_ATTRIBUTE_IMG_IMG_BROWSER_FILE_RAW uint8_t img_browser_file_raw_map[] = {
#if LV_COLOR_DEPTH == 1 || LV_COLOR_DEPTH == 8
  /*Pixel format: Red: 3 bit, Green: 3 bit, Blue: 2 bit*/
  0xe3, 0x17, 0x17, 0x17, 0x17, 0x17, 0x17, 0x17, 0x17, 0x17, 0x17, 0x17, 0x17, 0xe3, 0xe3, 0xe3, 0xe3, 0xe3, 0xe3, 0xe3, 0xe3, 0xe3, 0xe3, 0xe3, 0xe3, 0xe3, 
  0xe3, 0x17, 0x17, 0x17, 0x17, 0x17, 0x17, 0x17, 0x17, 0x17, 0x17, 0x17, 0x17, 0x17, 0xe3, 0xe3, 0xe3, 0xe3, 0xe3, 0xe3, 0xe3, 0xe3, 0xe3, 0xe3, 0xe3, 0xe3, 
  0xe3, 0x17, 0x17, 0x00, 0x00, 0x00, 0x00, 0x00, 0x00, 0x00, 0x00, 0x00, 0x00, 0x17, 0x17, 0xe3, 0xe3, 0xe3, 0xe3, 0xe3, 0xe3, 0xe3, 0xe3, 0xe3, 0xe3, 0xe3, 
  0xe3, 0x17, 0x17, 0x00, 0x00, 0x00, 0x00, 0x00, 0x00, 0x00, 0x00, 0x00, 0x00, 0x00, 0x17, 0x17, 0xe3, 0xe3, 0xe3, 0xe3, 0xe3, 0xe3, 0xe3, 0xe3, 0xe3, 0xe3, 
  0xe3, 0x17, 0x17, 0x00, 0x00, 0x00, 0x00, 0x00, 0x04, 0x05, 0x0a, 0x0e, 0x13, 0x0e, 0x00, 0x17, 0x17, 0xe3, 0xe3, 0xe3, 0xe3, 0xe3, 0xe3, 0xe3, 0xe3, 0xe3, 
  0xe3, 0x17, 0x17, 0x00, 0x00, 0x00, 0x00, 0x00, 0x0e, 0x17, 0x17, 0x17, 0x13, 0x13, 0x00, 0x00, 0x17, 0x17, 0xe3, 0xe3, 0xe3, 0xe3, 0xe3, 0xe3, 0xe3, 0xe3, 
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
  0xff, 0x00, 0xff, 0xff, 0xe2, 0xa4, 0x00, 0xff, 0xe2, 0xa4, 0x00, 0xff, 0xe2, 0xa4, 0x00, 0xff, 0xe2, 0xa4, 0x00, 0xff, 0xe2, 0xa4, 0x00, 0xff, 0xe2, 0xa4, 0x00, 0xff, 0xe2, 0xa4, 0x00, 0xff, 0xe2, 0xa4, 0x00, 0xff, 0xe2, 0xa4, 0x00, 0xff, 0xe2, 0xa4, 0x00, 0xff, 0xe2, 0xa4, 0x00, 0xff, 0xe2, 0xa4, 0x00, 0xff, 0xe2, 0xa4, 0x00, 0xff, 0xe2, 0xa4, 0x00, 0xff, 0xe2, 0xa4, 0x00, 0xff, 0xe2, 0xa4, 0x00, 0xff, 0xe2, 0xa4, 0x00, 0xff, 0xe2, 0xa4, 0x00, 0xff, 0xff, 0x00, 0xff, 0xff, 0xff, 0x00, 0xff, 0xff, 0xff, 0x00, 0xff, 0xff, 0xff, 0x00, 0xff, 0xff, 0xff, 0x00, 0xff, 0xff, 0xff, 0x00, 0xff, 0xff, 0xff, 0x00, 0xff, 0xff, 
#endif
};

const lv_img_dsc_t img_browser_file_raw = {
  .header.cf = LV_IMG_CF_TRUE_COLOR_CHROMA_KEYED,
  .header.always_zero = 0,
  .header.reserved = 0,
  .header.w = 26,
  .header.h = 21,
  .data_size = 546 * LV_COLOR_SIZE / 8,
  .data = img_browser_file_raw_map,
};
