baoshi/VGMPlayer/sw/main/modules/display/img_battery_charging.c

#if defined(LV_LVGL_H_INCLUDE_SIMPLE)
#include "lvgl.h"
#else
#include "lvgl/lvgl.h"
#endif


#ifndef LV_ATTRIBUTE_MEM_ALIGN
#define LV_ATTRIBUTE_MEM_ALIGN
#endif

#ifndef LV_ATTRIBUTE_IMG_IMG_BATTERY_CHARGING
#define LV_ATTRIBUTE_IMG_IMG_BATTERY_CHARGING
#endif

const LV_ATTRIBUTE_MEM_ALIGN LV_ATTRIBUTE_LARGE_CONST LV_ATTRIBUTE_IMG_IMG_BATTERY_CHARGING uint8_t img_battery_charging_map[] = {
#if LV_COLOR_DEPTH == 1 || LV_COLOR_DEPTH == 8
  /*Pixel format: Red: 3 bit, Green: 3 bit, Blue: 2 bit*/
  0xe3, 0xb6, 0xb6, 0xb6, 0xb6, 0xb6, 0xb6, 0xb6, 0xb6, 0xb6, 0xb6, 0xb6, 0xb6, 0x96, 0xb6, 0xb6, 0xb6, 0xb6, 0xb6, 0xb6, 0xb6, 0xb6, 0xe3, 0xe3, 0xe3, 0xe3, 
  0xb6, 0xb6, 0x00, 0x00, 0x00, 0x00, 0x00, 0x00, 0x00, 0x00, 0x00, 0x24, 0x49, 0x29, 0x00, 0x00, 0x00, 0x00, 0x00, 0x00, 0x00, 0xb6, 0xb6, 0xe3, 0xe3, 0xe3, 
  0xb6, 0x00, 0x00, 0x1c, 0x1c, 0x1c, 0x1c, 0x1c, 0x1c, 0x1c, 0x1c, 0x35, 0x28, 0x39, 0x1c, 0x1c, 0x1c, 0x1c, 0x1c, 0x1c, 0x00, 0x00, 0xb6, 0xe3, 0xe3, 0xe3, 
  0xb6, 0x00, 0x1c, 0x1c, 0x1c, 0x1c, 0x1c, 0x1c, 0x1c, 0x1c, 0x39, 0x24, 0x2c, 0x1c, 0x1c, 0x1c, 0x1c, 0x1c, 0x1c, 0x1c, 0x1c, 0x00, 0xb6, 0xe3, 0xb6, 0xe3, 
  0xb6, 0x00, 0x1c, 0x1c, 0x1c, 0x1c, 0x1c, 0x1c, 0x1c, 0x3d, 0x28, 0x04, 0x39, 0x1c, 0x1c, 0x1c, 0x1c, 0x1c, 0x1c, 0x1c, 0x1c, 0x00, 0xb6, 0xe3, 0xe3, 0xb6, 
  0xb6, 0x00, 0x1c, 0x1c, 0x1c, 0x1c, 0x1c, 0x1c, 0x3d, 0x2d, 0x00, 0x04, 0x35, 0x39, 0x35, 0x39, 0x1c, 0x1c, 0x1c, 0x1c, 0x1c, 0x00, 0xb6, 0xe3, 0xe3, 0xb6, 
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
#endif
};

const lv_img_dsc_t img_battery_charging = {
  .header.cf = LV_IMG_CF_TRUE_COLOR_CHROMA_KEYED,
  .header.always_zero = 0,
  .header.reserved = 0,
  .header.w = 26,
  .header.h = 13,
  .data_size = 338 * LV_COLOR_SIZE / 8,
  .data = img_battery_charging_map,
};
