baoshi/VGMPlayer/sw/main/modules/backlight/backlight.h

#pragma once

#include <stdint.h>

#ifdef __cplusplus
extern "C" {
#endif

void backlight_init(int8_t normal, int8_t dimmed);
void backlight_set(int8_t percentage, uint32_t transition);
void backlight_set_direct(int8_t percentage);
void backlight_restore(void);
void backlight_dim(void);
void backlight_update(uint32_t now);

int8_t backlight_get();

#ifdef __cplusplus
}
#endif
