baoshi/VGMPlayer/sw/main/modules/ec/ec.h

#ifndef EC_H
#define EC_H

#include <stdint.h>
#include <stdbool.h>

#ifdef __cplusplus
extern "C" {
#endif

#define EC_KEY_MASK_NW    0x01
#define EC_KEY_MASK_SW    0x02
#define EC_KEY_MASK_PLAY  0x04
#define EC_KEY_MASK_NE    0x08
#define EC_KEY_MASK_SE    0x10

extern bool ec_charge;          // true if charging
extern float ec_battery;        // battery voltage
extern uint8_t ec_keys;         // key states

void ec_init(void);
int  ec_update(uint32_t now);
void ec_power_off(void);
void ec_pause_watchdog(void);
void ec_resume_watchdog(void);

#ifdef __cplusplus
}
#endif

#endif
