baoshi/VGMPlayer/sw/main/modules/display/display.c

#include <pico/time.h>
#include <lvgl.h>
#include "st7789.h"
#include "lvstyle.h"
#include "lvtheme.h"
#include "display.h"


void display_init()
{
    lv_init();
    st7789_lvgl_init();
    lvs_init(); // Custom Styles
    lv_disp_t* disp = lv_disp_get_default();
    lv_disp_set_theme(disp, lvt_init(disp));
}
