baoshi/VGMPlayer/(commit log)

2021-05-17 Initial hw commit
    [VGMPlayer.kicad_pcb, VGMPlayer.sch]
2021-06-07 2nd version, change KBC functions
    [VGMPlayer.kicad_pcb, VGMPlayer.sch]
2021-06-07 Add KPC software flowchart
2021-06-07 Using Molex Picoblade 1.25 connector
    [VGMPlayer.kicad_pcb, VGMPlayer.sch]
2021-06-08 Fix wrong 2N7002 pinout
    [VGMPlayer.kicad_pcb]
2021-06-09 USB/Batt power path
    [VGMPlayer.sch]
2021-06-10 Checkin before fab 20210610
    [VGMPlayer.kicad_pcb, VGMPlayer.sch]
2021-06-10 Sent for fab 20210610
    [VGMPlayer.kicad_pcb, VGMPlayer.sch]
2021-06-24 Change to 4 buttons, layout adjust to casing design
    [VGMPlayer.kicad_pcb, VGMPlayer.sch]
2021-06-27 Change 2N7002 footprint to SOT-523
    [VGMPlayer.kicad_pcb, VGMPlayer.sch]
2021-06-27 Fix SWD connector orientation
    [VGMPlayer.kicad_pcb, VGMPlayer.sch]
2021-06-27 Remove SD card bypass capacitor (very close to main filter cap)
    [VGMPlayer.kicad_pcb, VGMPlayer.sch]
2021-07-01 Initial commit of EC code
    [VGMPlayer.kicad_pcb]
2021-07-01 sleep current testing
2021-07-04 Add analog power selection jumper and multiple button options
    [VGMPlayer.kicad_pcb, VGMPlayer.sch]
2021-07-05 more pcb editing
    [VGMPlayer.kicad_pcb]
2021-07-05 More state machine including LED
2021-07-12 Fix LCD wiring
    [VGMPlayer.kicad_pcb, VGMPlayer.sch]
2021-07-14 Further layout optimize
    [VGMPlayer.kicad_pcb]
2021-07-14 Tag for Fab-20210714
    [VGMPlayer.kicad_pcb]
2021-07-15 Rename button labels
    [VGMPlayer.kicad_pcb, VGMPlayer.sch]
2021-08-06 Wakeup only check button down
2022-02-07 Using Linux Kicad 6.0.1
    [VGMPlayer.kicad_pcb]
2022-02-07 Upgrade KiCad 6.0.1 Linux
    [VGMPlayer.kicad_sch]
2022-02-18 fix event queue using spin lock
    [event.h, event_ids.h, event_queue.c, event_queue.h, main.c, tick.c]
2022-02-22 WIP: New WM8978 driver
2022-02-23 Testing rockbox wm8978 driver
2022-02-23 fix browser state starts into nodisk state
    [browser.c]
2022-02-25 add mode button navigation in browser_disk
2022-02-27 add sample decoder
2022-02-27 Playback stop / restart fixing
    [audio.c, hw_conf.h, i2s.c, i2s.h, wm8978.c]
2022-03-03 V4 hardware
    [VGMPlayer.kicad_sch]
2022-03-06 V4 hardware send for JLC
    [VGMPlayer.kicad_pcb, VGMPlayer.kicad_sch]
2022-04-07 Use new iPhone8 measurement
    [VGMPlayer.kicad_pcb]
2022-05-10 Add new EC (5 buttons) code with tester
2022-05-10 Temporary disable i2c activity tracker
2022-05-10 Modify I2C data0 bits
2022-05-12 Change to 5 buttons
2022-05-12 update buttons
2022-05-12 Fix jack detection gpio/adc error
    [audio.c, hw_conf.h]
2022-06-18 fix last entry index error
    [lister.c]
2022-06-18 fix empty directory bug
    [lister.c]
2022-06-24 Implement new player key bindings
    [app.h, browser.c, catalog.c, event_ids.h, main.c]
2022-06-26 Modified HSM. When event was handled by higher state in the hierarchy, and transition appens, transit happs from current state instead of higher state.
2022-06-26 Use single callback for h/w buttons
2022-07-01 Add i2c soft reset to prevent EC bad state
    [global.h, hw_conf.c, i2c.c, i2c.h, main.c, st7789.c, state_main.c]
2022-07-24 WIP input change
    [main_input.xlsx]
2022-07-24 Implementing input setup
    [main_input.xlsx]
2022-07-24 modify input for setting
    [main_input.xlsx]
2022-07-25 auto advance in player
    [main_input.xlsx]
2022-07-28 Update inputs
    [main_input.xlsx]
2022-08-01 save setting, fix audio ramp bug
    [app.h, audio.c, popup_brightness.c, popup_volume.c, state_player.c]
2022-08-02 Notify player for sample ready
2022-08-21 remove DMA ISR in ST7789
2022-08-24 wip trouble shooting performace issue
    [app.h, audio.c, audio.h, audio_buffer.c, decoder_vgm.c, hw_conf.h, i2s.c, i2s.h]
2022-08-27 Use fifo for comm, fix card eject playback error
    [audio.c]
2022-08-27 fix auto play next song fail
    [audio.c]
2022-08-28 Increase audio frame length
2022-09-04 testing battery icon
2022-09-05 add battery monitor in top state
2022-09-05 Get back ST7789 DMA
2022-09-05 fix eject when playing and insert card list empty
    [state_browser.c]
2022-09-08 add vgz2vgm, add file pattern filter
2022-09-10 track master vgmcore
2022-09-10 fix top label size problem
    [state_player.c]
2022-09-29 handle vgm creation error
    [state_player.c]
2022-09-30 Update switch names
    [VGMPlayer.kicad_pcb, VGMPlayer.kicad_sch]
2022-10-01 Add power off function
    [main_input.xlsx]
2022-10-01 Move display dimming and auto off to powerman
2022-10-08 Set board thickness to 1mm
    [VGMPlayer.kicad_pcb]
2023-02-13 Save with KiCad 7.0
    [VGMPlayer.kicad_pcb, VGMPlayer.kicad_sch]
2023-03-17 solve build error in linux
    [audio.c]
2023-03-19 Update lvgl submodule to track github repo
